mingzejin11/FYDP/hardware/Images/3D PCB with names.png

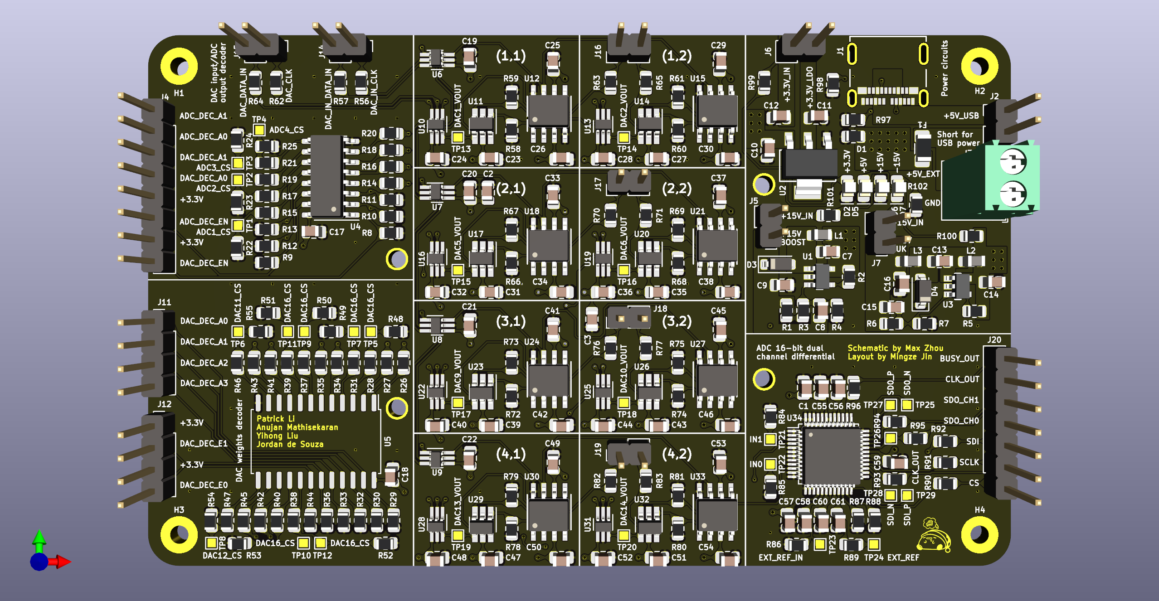
hardware/Images/3D PCB with names.png
