mingzejin11/FYDP/hardware/Images/3D PCB front 2.png

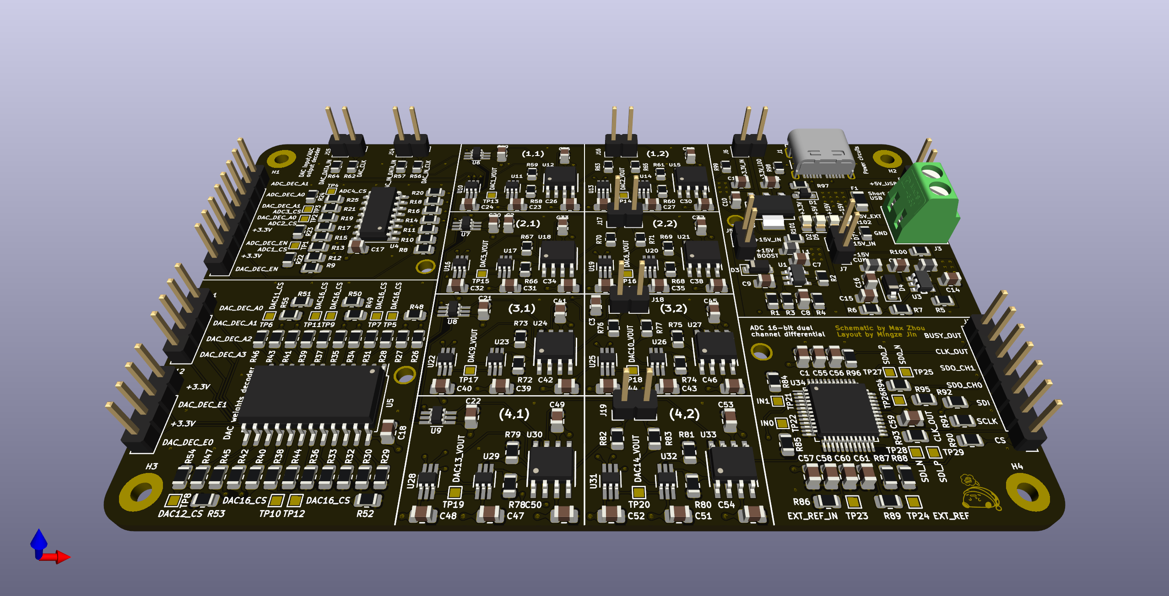
hardware/Images/3D PCB front 2.png
