mingzejin11/FYDP/hardware/fydp/BLOCK_DIAGRAM.png

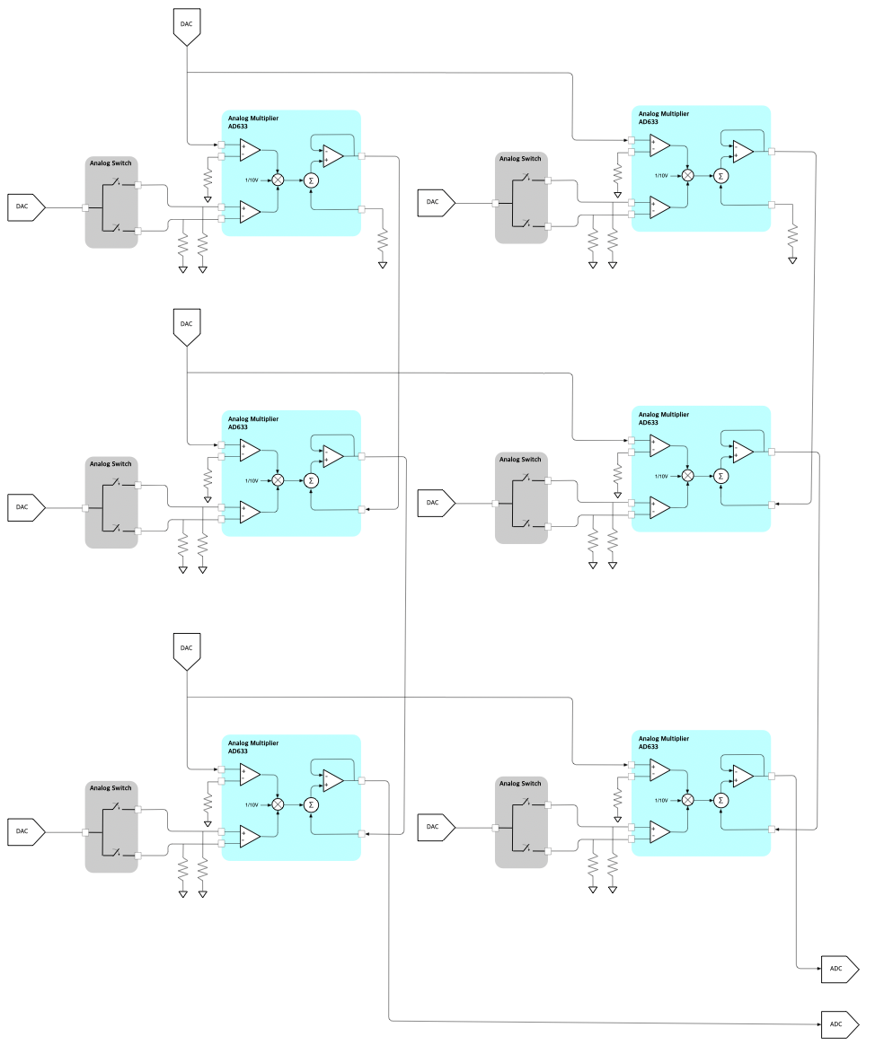
hardware/fydp/BLOCK_DIAGRAM.png
