mingzejin11/FYDP/hardware/Images/3D PCB back.png

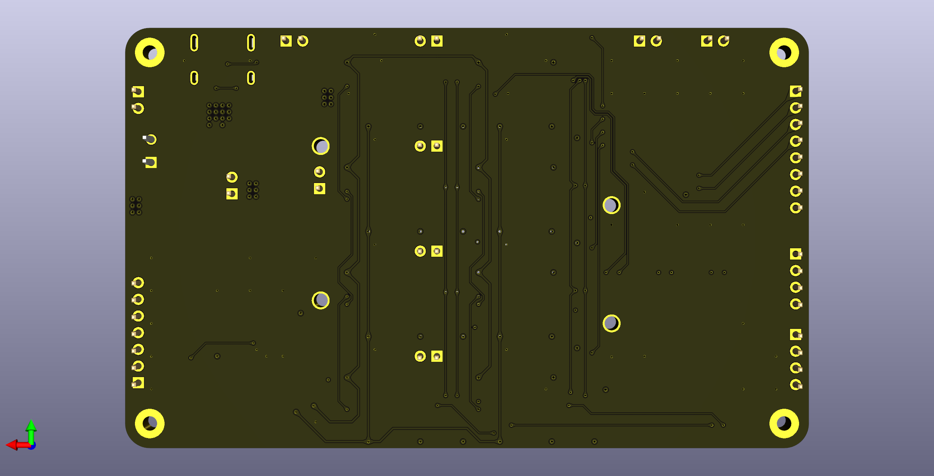
hardware/Images/3D PCB back.png
