mingzejin11/FYDP/hardware/Images/3D PCB front.png

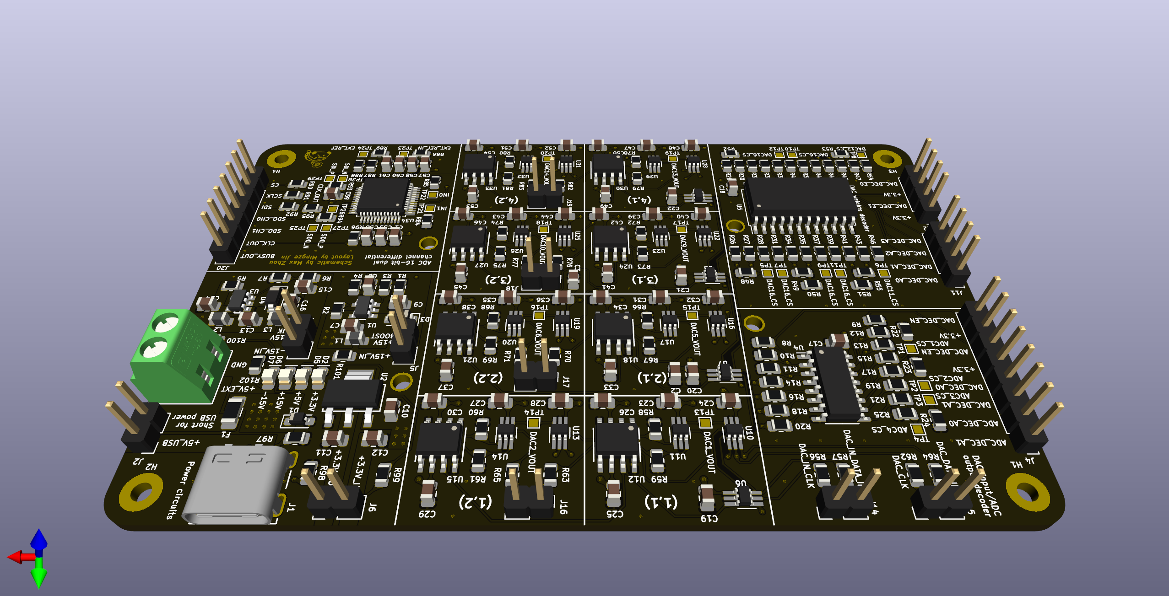
hardware/Images/3D PCB front.png
