mingzejin11/FYDP/hardware/Images/3D PCB.png

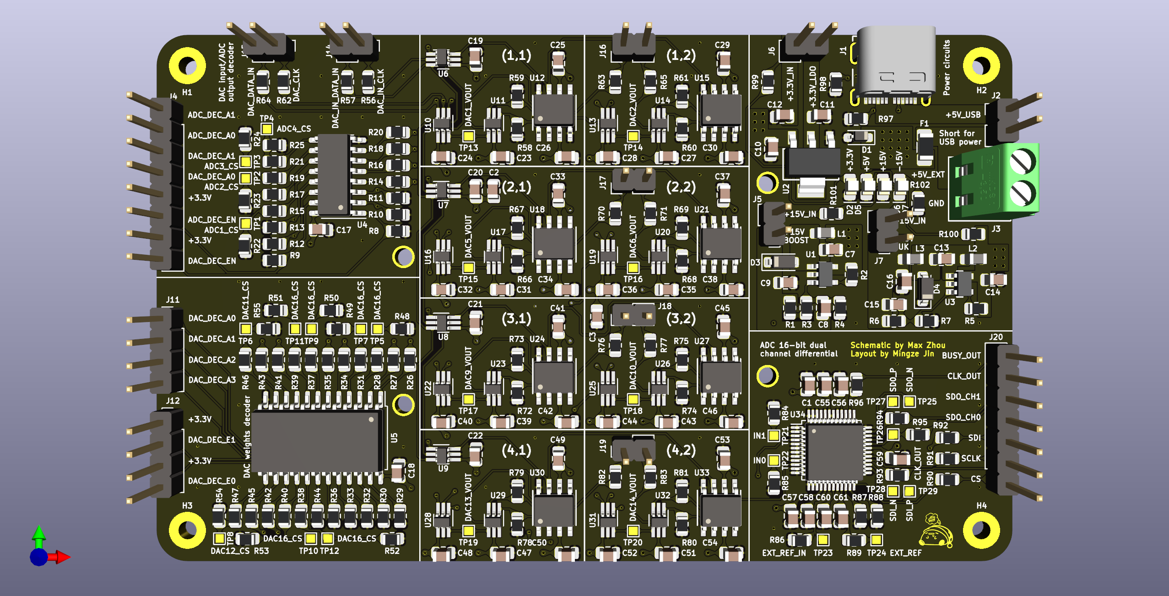
hardware/Images/3D PCB.png
