mingzejin11/FYDP/hardware/Images/fydp.png

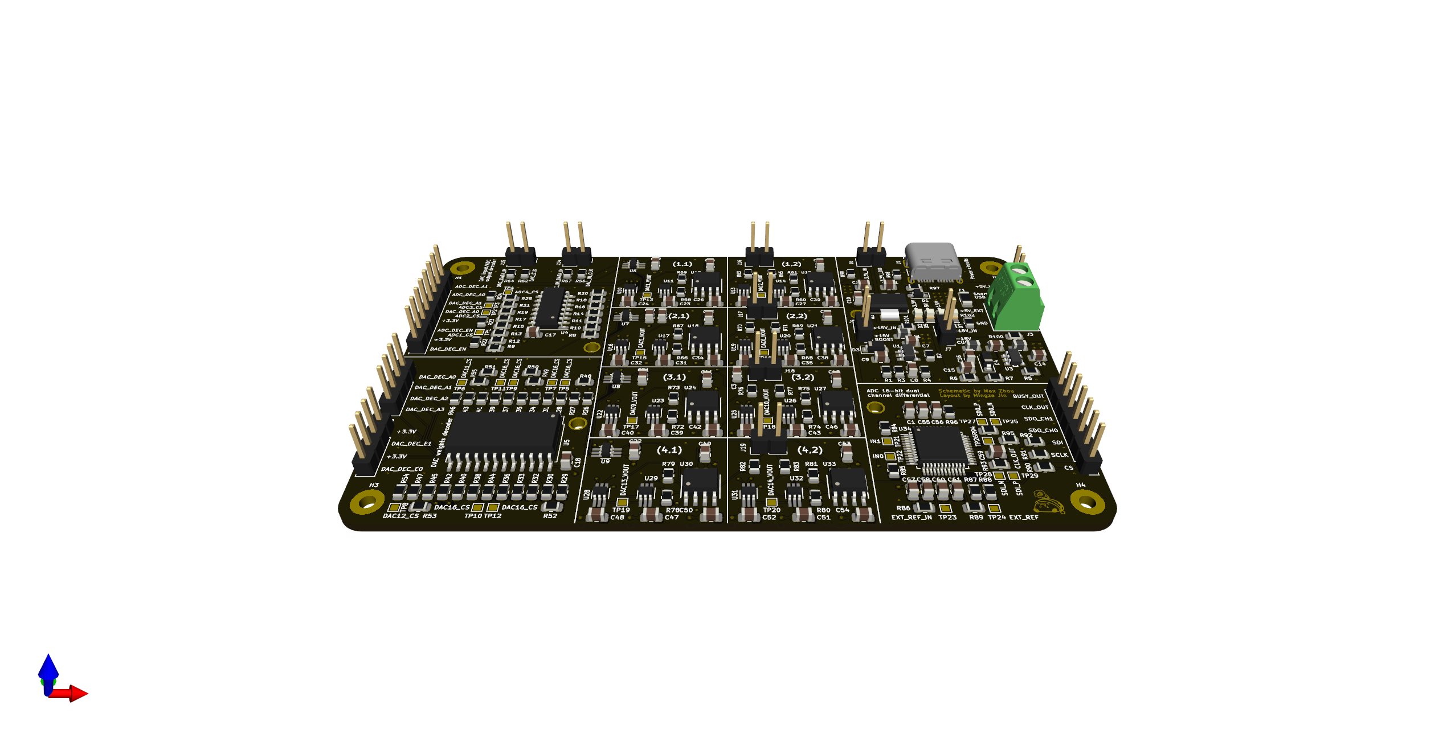
hardware/Images/fydp.png
