mingzejin11/FYDP/hardware/Images/PCB Layout.png

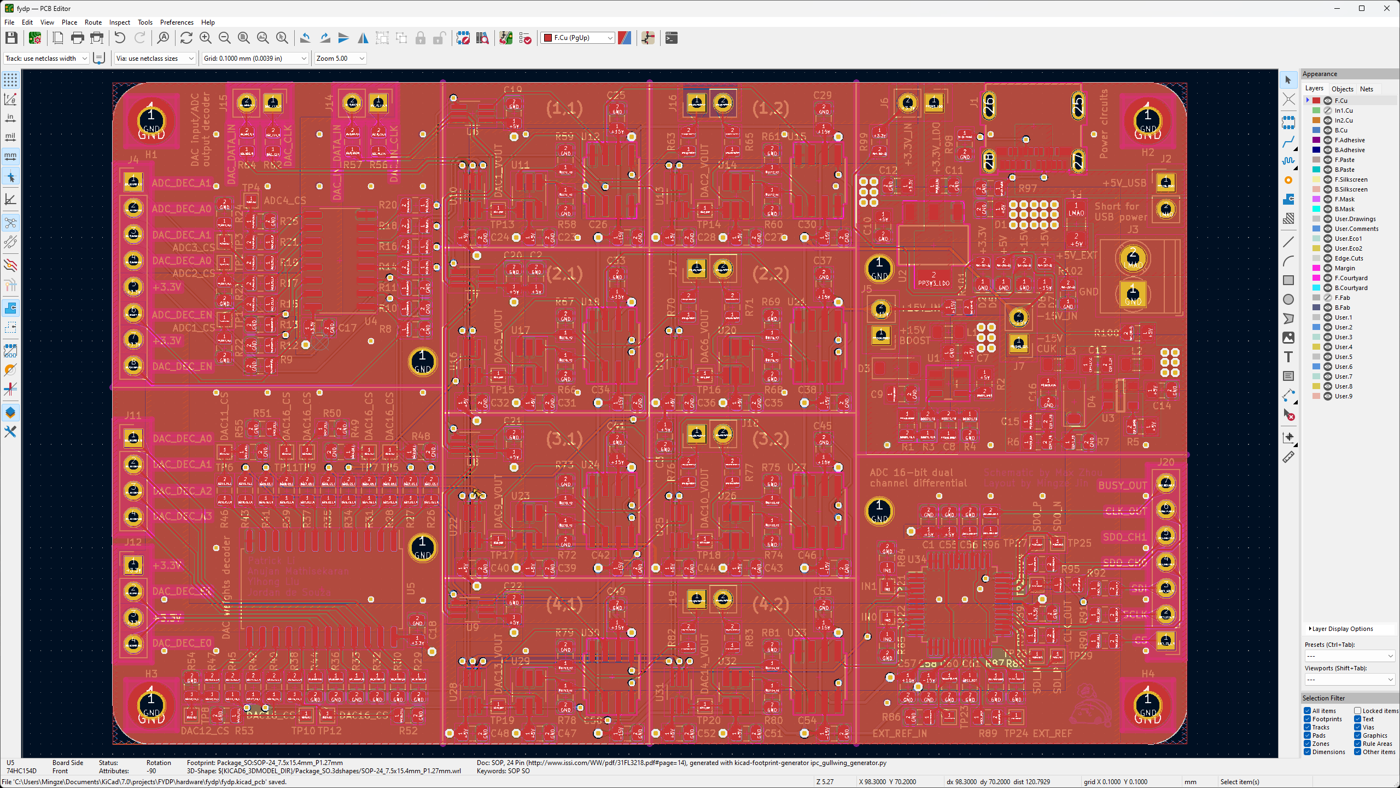
hardware/Images/PCB Layout.png
