mingzejin11/FYDP/Renderings/Animation.gif

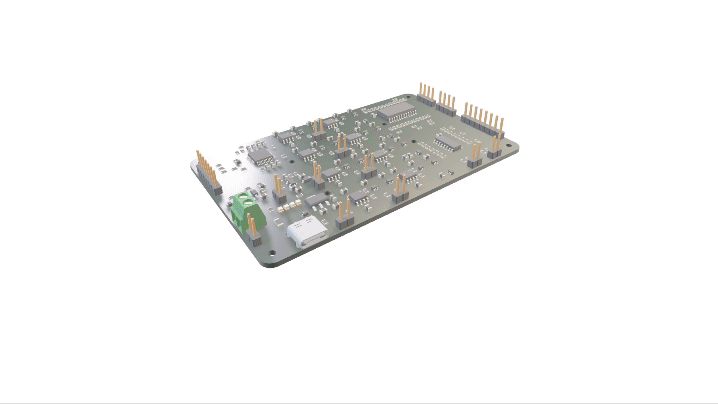
Renderings/Animation.gif
