mingzejin11/FYDP/hardware/Case/DXF/2007/FYDP Case.dxf

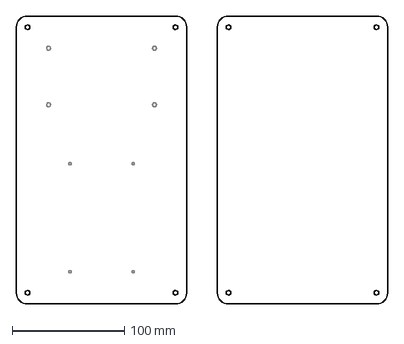
[picture p12: CAD file, 2024-03-12]
hardware/Case/DXF/2007/FYDP Case.dxf
331.3 x 257.0 mm
