mingzejin11/FYDP/hardware/Case/KiCAD DXF/fydp-B_Cu.dxf

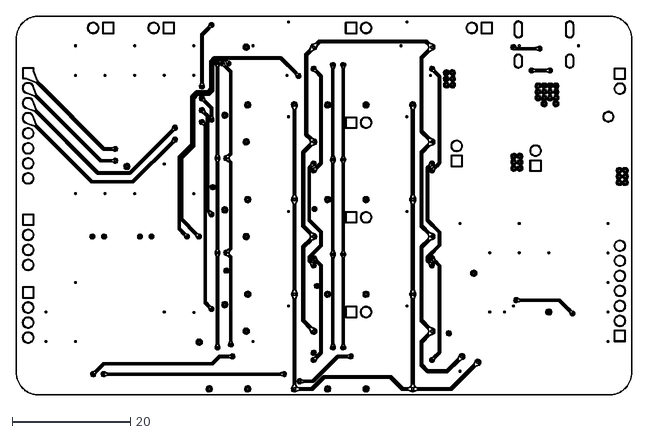
[picture p16: CAD file, 2024-03-11]
hardware/Case/KiCAD DXF/fydp-B_Cu.dxf
104.0 x 64.0
