mingzejin11/FYDP/hardware/Components/AZ1117IH-3.3TRG1/SOT223-3.step

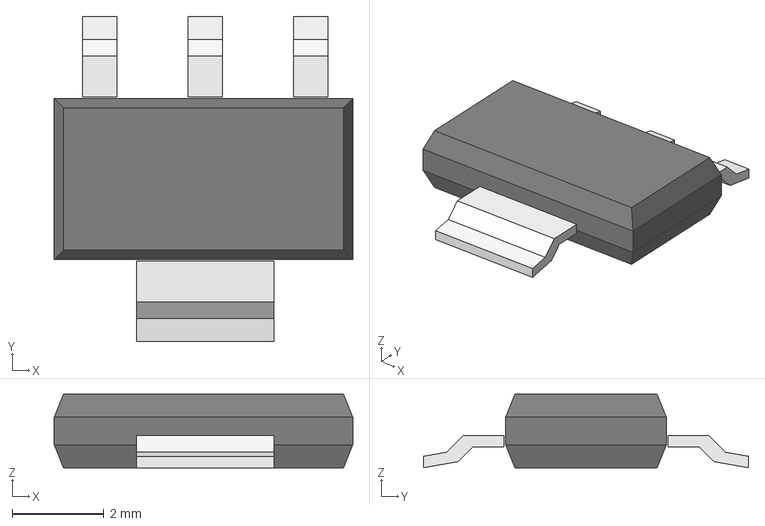
[picture p17: CAD file, 2024-02-02]
hardware/Components/AZ1117IH-3.3TRG1/SOT223-3.step
6.50 x 7.07 x 1.60 mm
