mingzejin11/FYDP/hardware/Components/LM2733YMFXNOPB/SOT23-5.stp

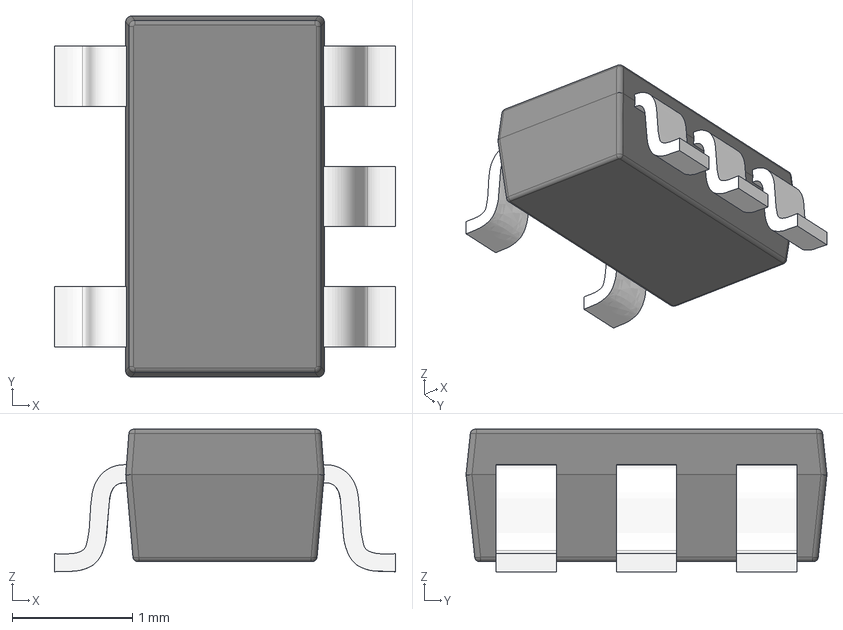
[picture p18: CAD file, 2024-02-02]
hardware/Components/LM2733YMFXNOPB/SOT23-5.stp
2.84 x 3.00 x 1.18 mm
