mingzejin11/FYDP/hardware/Case/DXF/2018/FYDP Case bottom.dxf

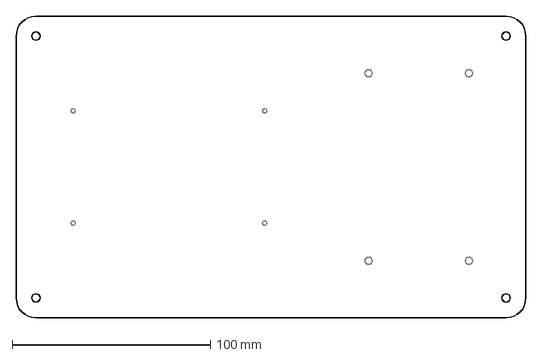
[picture p24: CAD file, 2024-03-11]
hardware/Case/DXF/2018/FYDP Case bottom.dxf
257.0 x 152.0 mm
