mingzejin11/FYDP/hardware/Case/DXF/2013/FYDP Case bottom.dxf

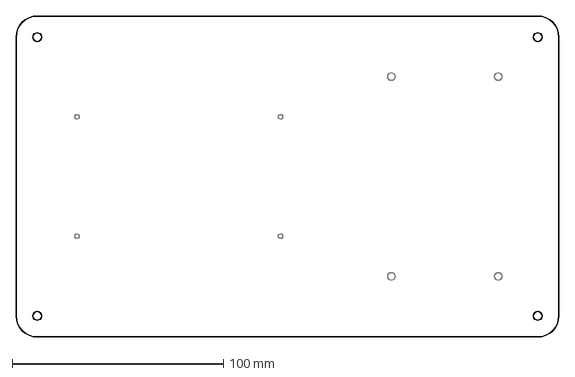
[picture p29: CAD file, 2024-03-11]
hardware/Case/DXF/2013/FYDP Case bottom.dxf
257.0 x 152.0 mm
