mingzejin11/FYDP/hardware/Case/DXF/2018/FYDP Case top.dxf

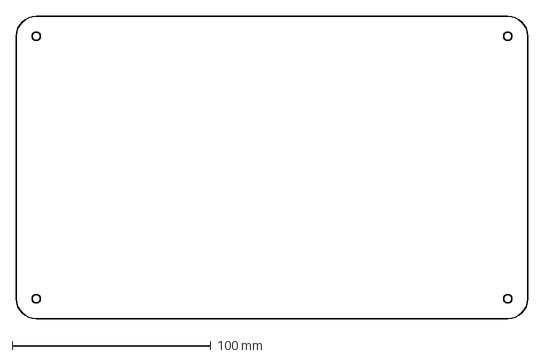
[picture p30: CAD file, 2024-03-11]
hardware/Case/DXF/2018/FYDP Case top.dxf
257.0 x 152.0 mm
