mingzejin11/FYDP/hardware/Case/KiCAD DXF/fydp-In1_Cu.dxf

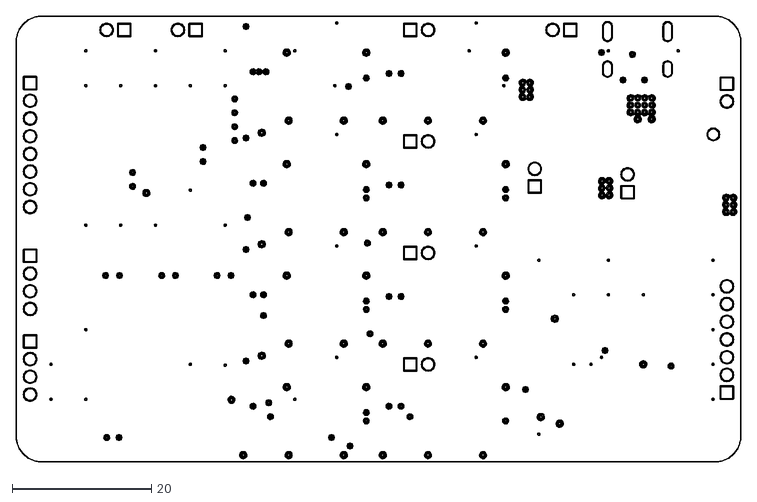
[picture p31: CAD file, 2024-03-11]
hardware/Case/KiCAD DXF/fydp-In1_Cu.dxf
104.0 x 64.0
