mingzejin11/FYDP/hardware/Case/KiCAD DXF/fydp-In2_Cu.dxf

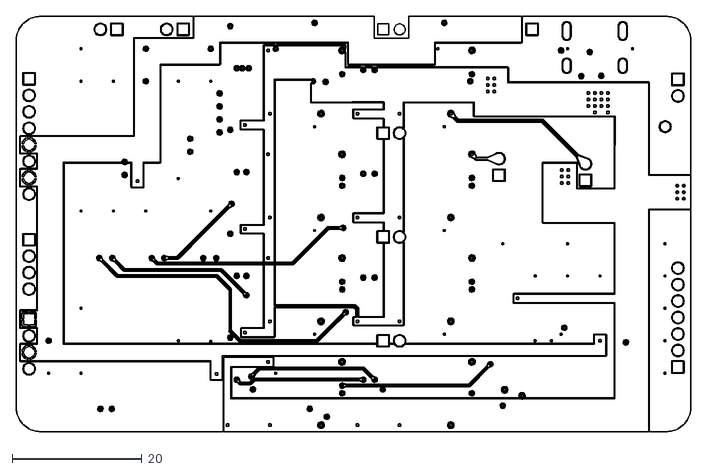
[picture p32: CAD file, 2024-03-11]
hardware/Case/KiCAD DXF/fydp-In2_Cu.dxf
104.0 x 64.0
