mingzejin11/FYDP/hardware/Case/KiCAD DXF/fydp-Edge_Cuts.dxf

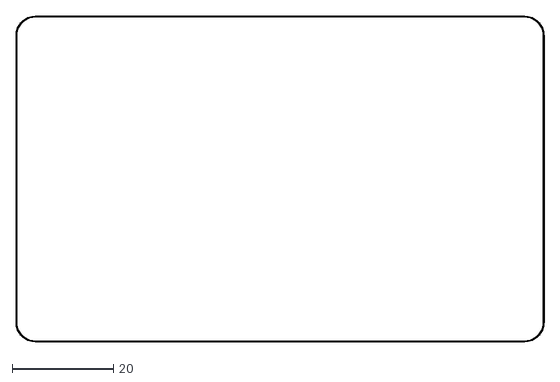
[picture p33: CAD file, 2024-03-11]
hardware/Case/KiCAD DXF/fydp-Edge_Cuts.dxf
104.1 x 64.1
