mingzejin11/FYDP/(list of files, cad)

Other CAD files:
hardware/Case/FYDP Case.dwg
hardware/Case/FYDP Case bottom.dwg
hardware/Case/KiCAD DXF/FYDP outline.dwg
hardware/Case/FYDP Case top.dwg
hardware/Case/KiCAD DXF/fydp-B_Mask.dxf
hardware/Case/KiCAD DXF/fydp-B_Paste.dxf
hardware/Case/KiCAD DXF/fydp-B_Silkscreen.dxf
hardware/Case/KiCAD DXF/fydp-F_Mask.dxf
hardware/Case/KiCAD DXF/fydp-F_Paste.dxf
