mingzejin11/FYDP/hardware/fydp/fydp.pdf

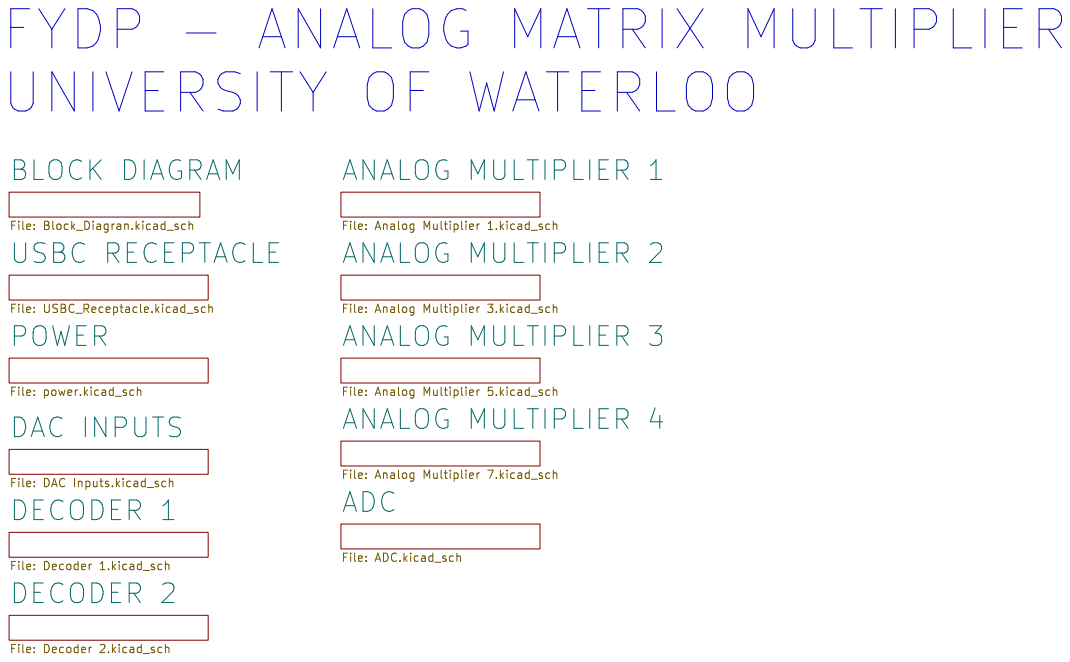
[picture p34: page 1]

File: ADC.kicad_sch FYDP - ANALOG MATRIX MULTIPLIER
UNIVERSITY OF WATERLOO

Id: 1/12 Title: File: fydp.kicad_sch Sheet: / BLOCK DIAGRAM

File: power.kicad_sch
File: Decoder 1.kicad_sch DAC INPUTS

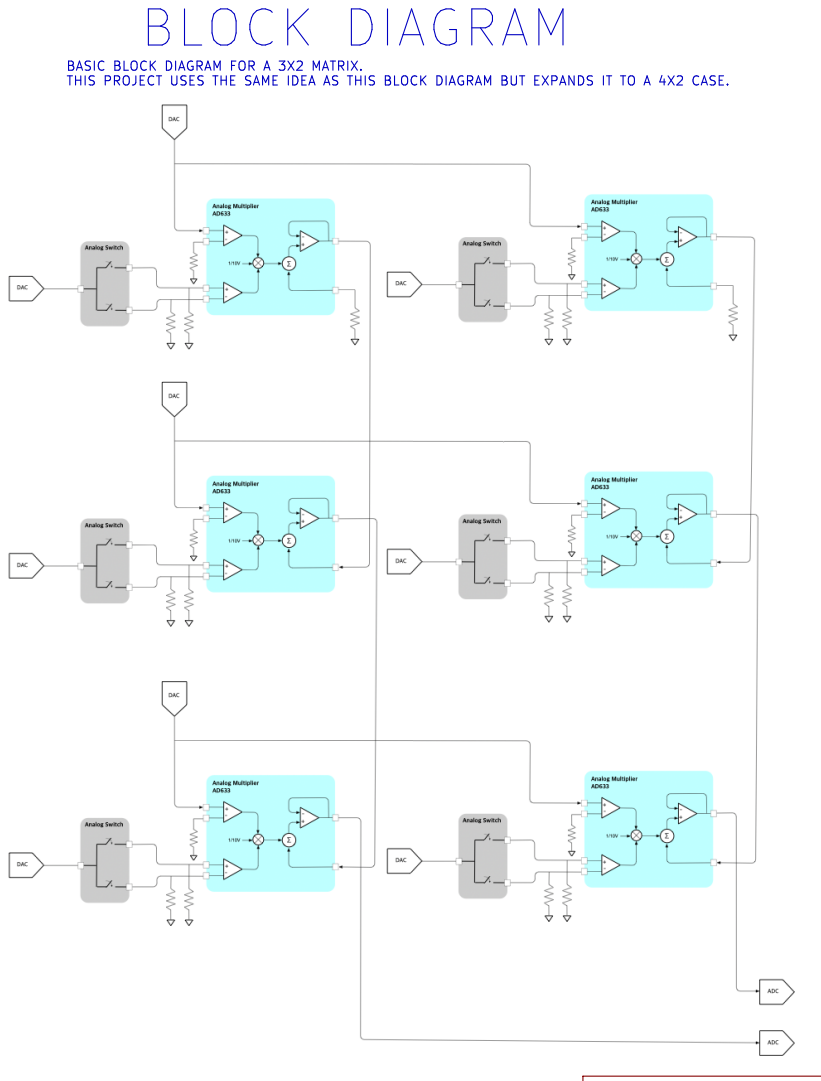
[picture p35: page 2]

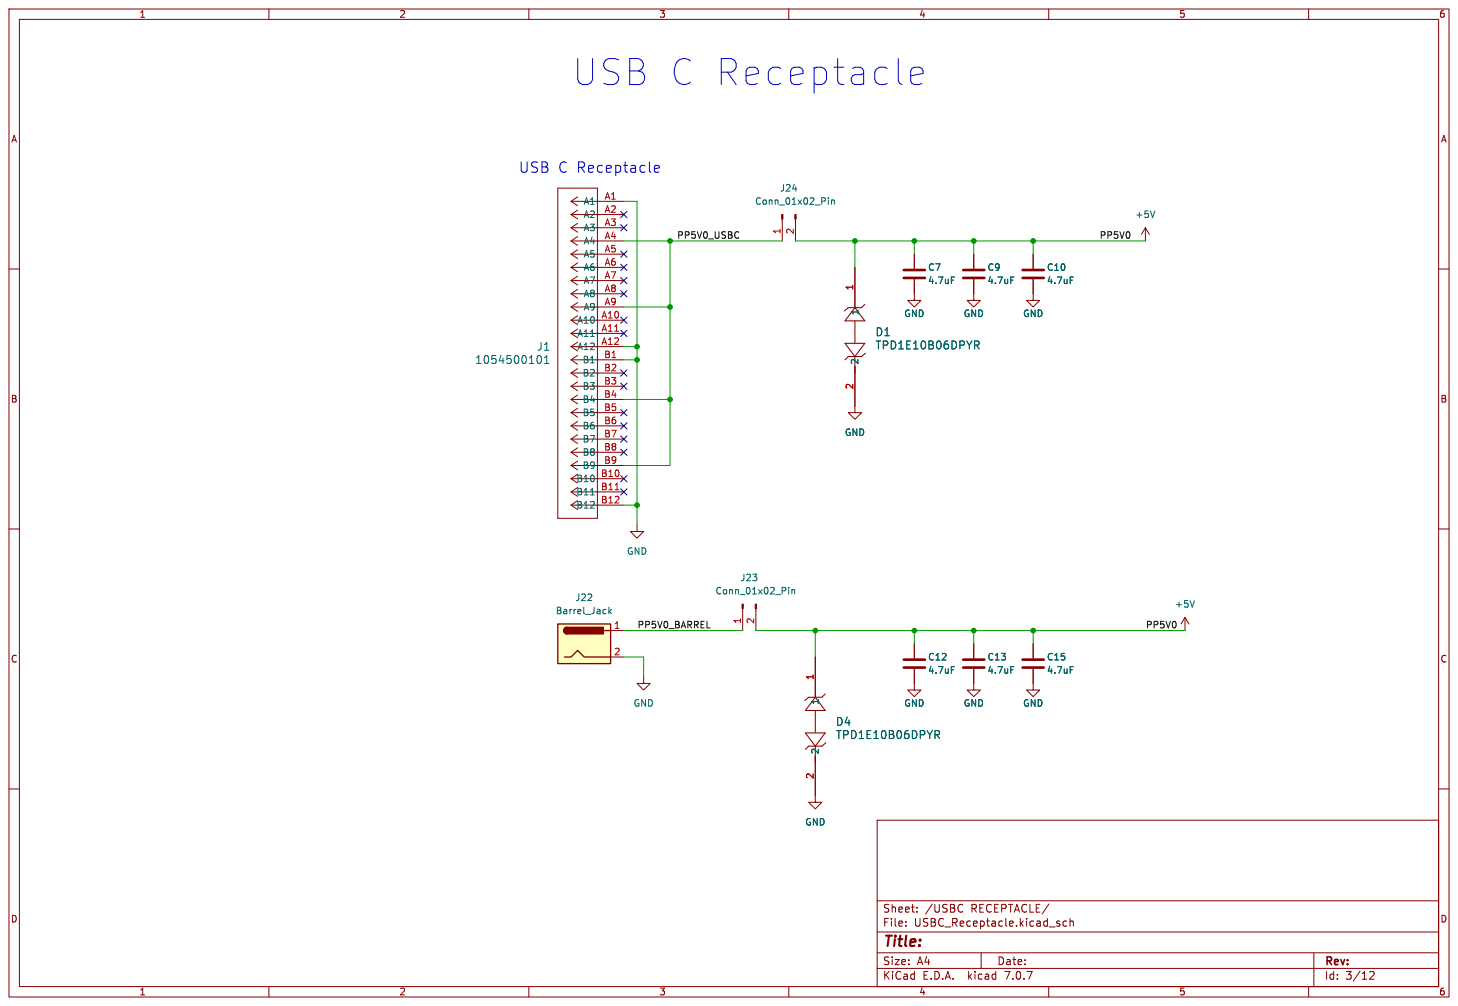
[picture p36: page 3]

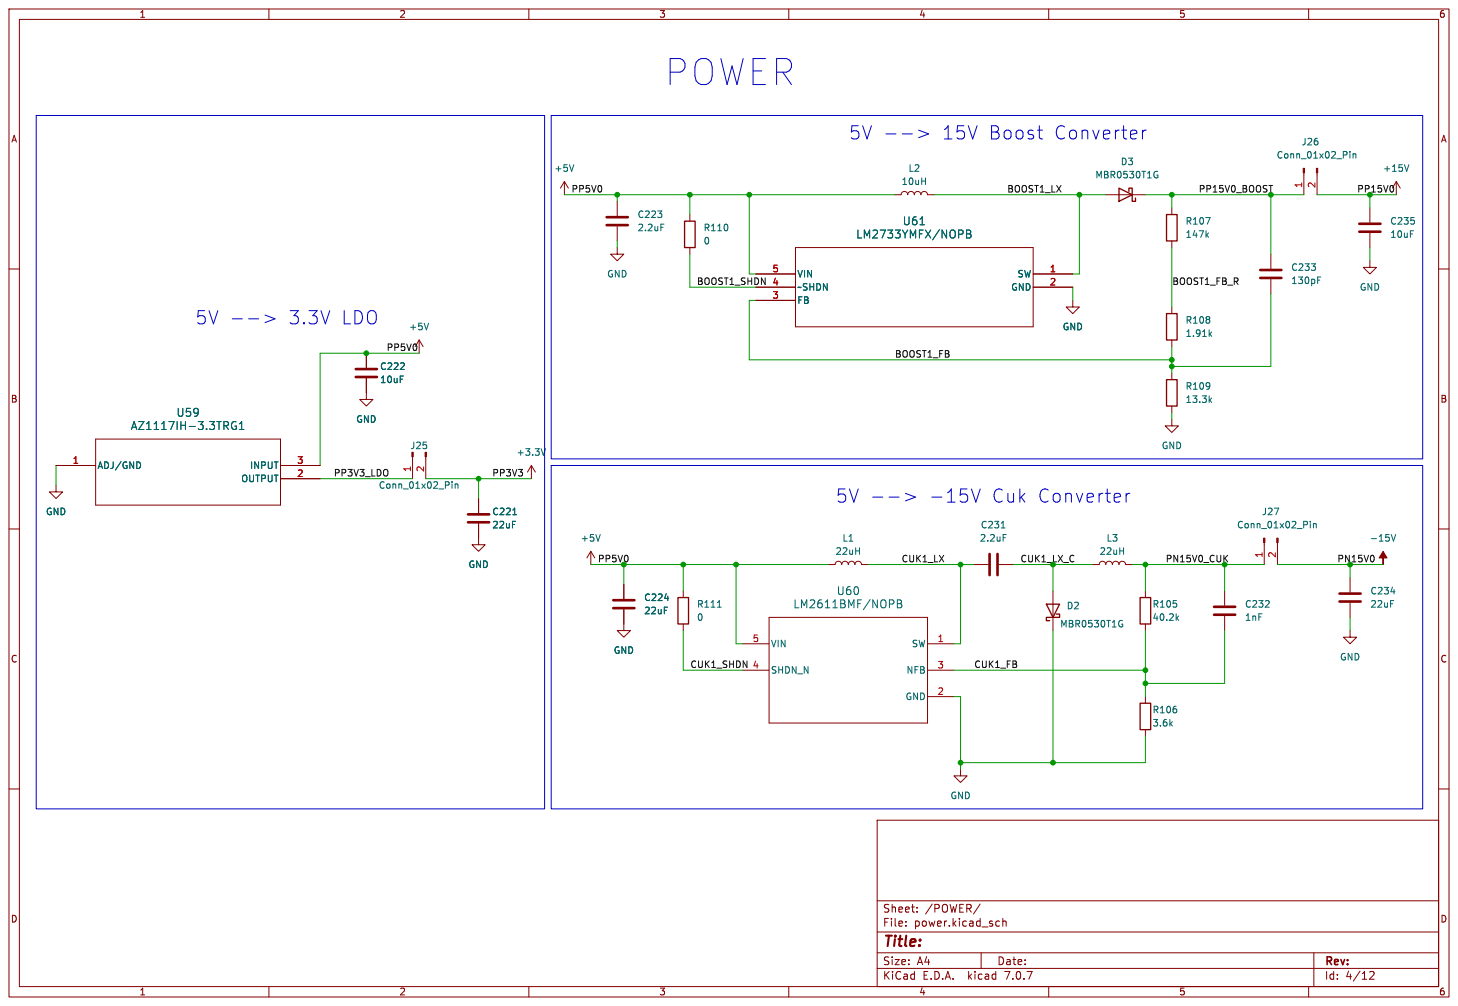
[picture p37: page 4]

Id: 4/12 Title: File: power.kicad_sch Sheet: /POWER/

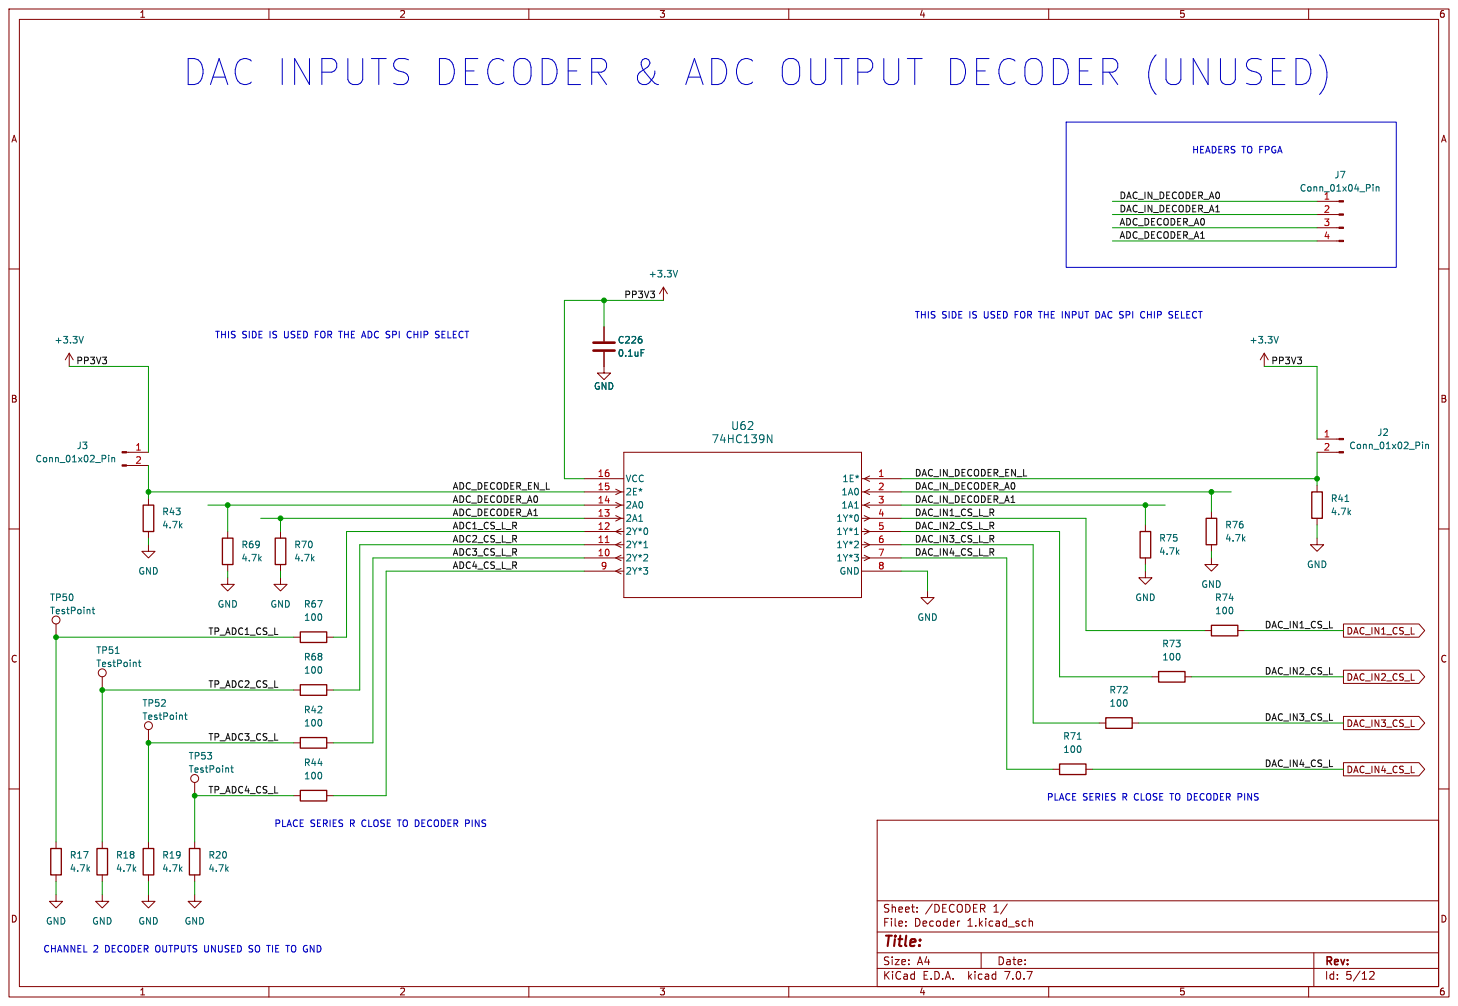
[picture p38: page 5]

DAC_IN4_CS_L_R DAC INPUTS DECODER & ADC OUTPUT DECODER (UNUSED)

THIS SIDE IS USED FOR THE INPUT DAC SPI CHIP SELECT CHANNEL 2 DECODER OUTPUTS UNUSED SO TIE TO GND

THIS SIDE IS USED FOR THE ADC SPI CHIP SELECT PLACE SERIES R CLOSE TO DECODER PINS

PLACE SERIES R CLOSE TO DECODER PINS

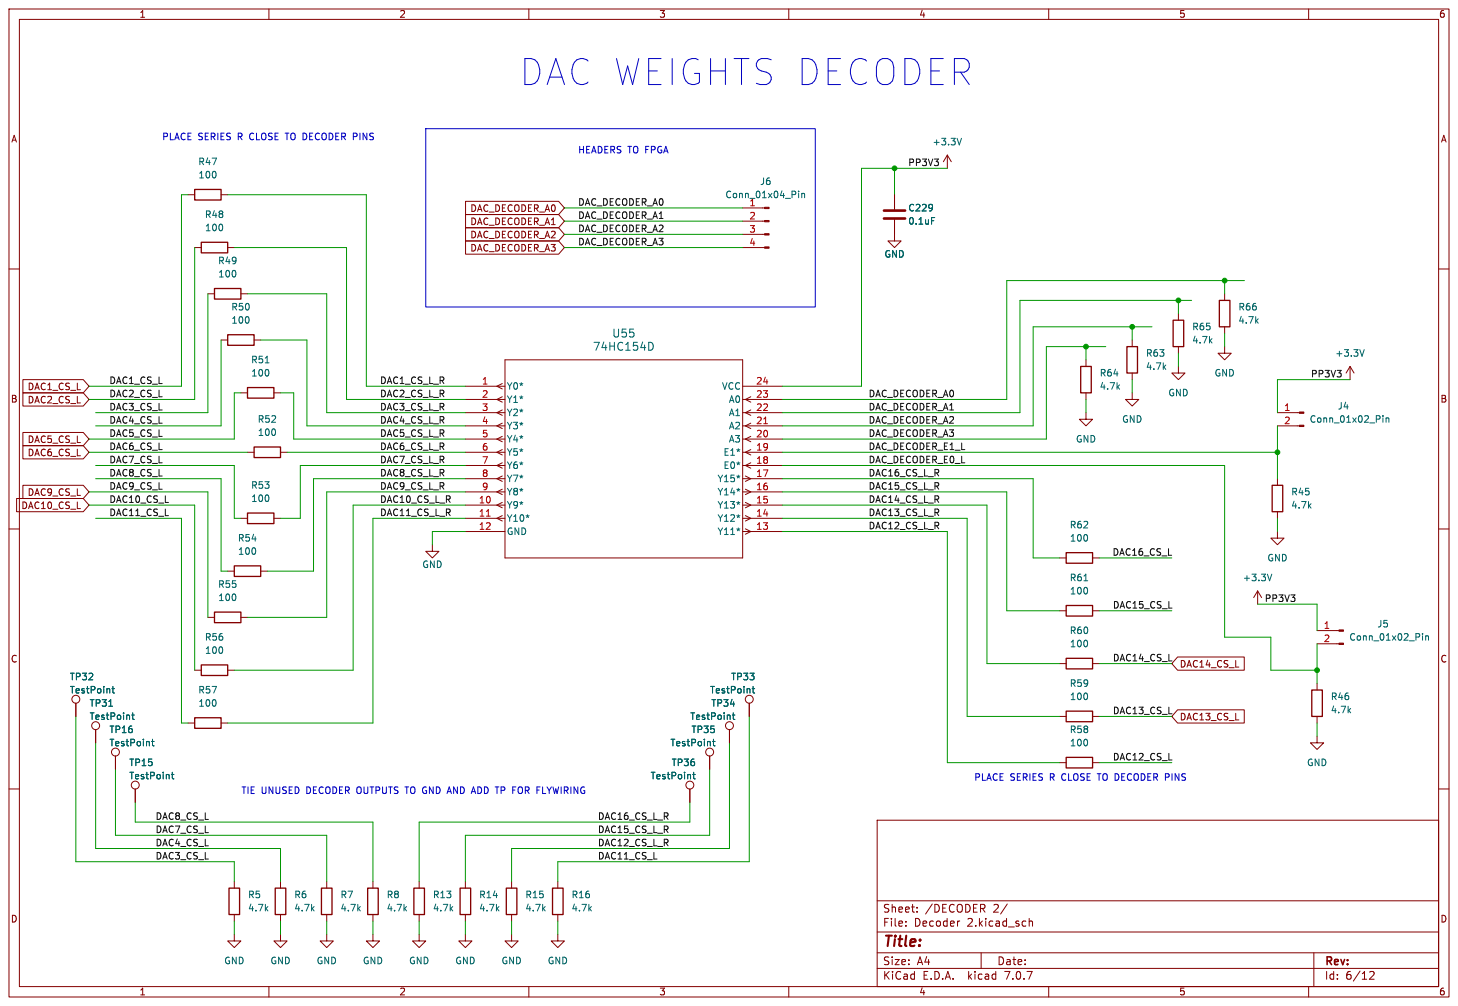
[picture p39: page 6]

TIE UNUSED DECODER OUTPUTS TO GND AND ADD TP FOR FLYWIRING DAC WEIGHTS DECODER

PLACE SERIES R CLOSE TO DECODER PINS

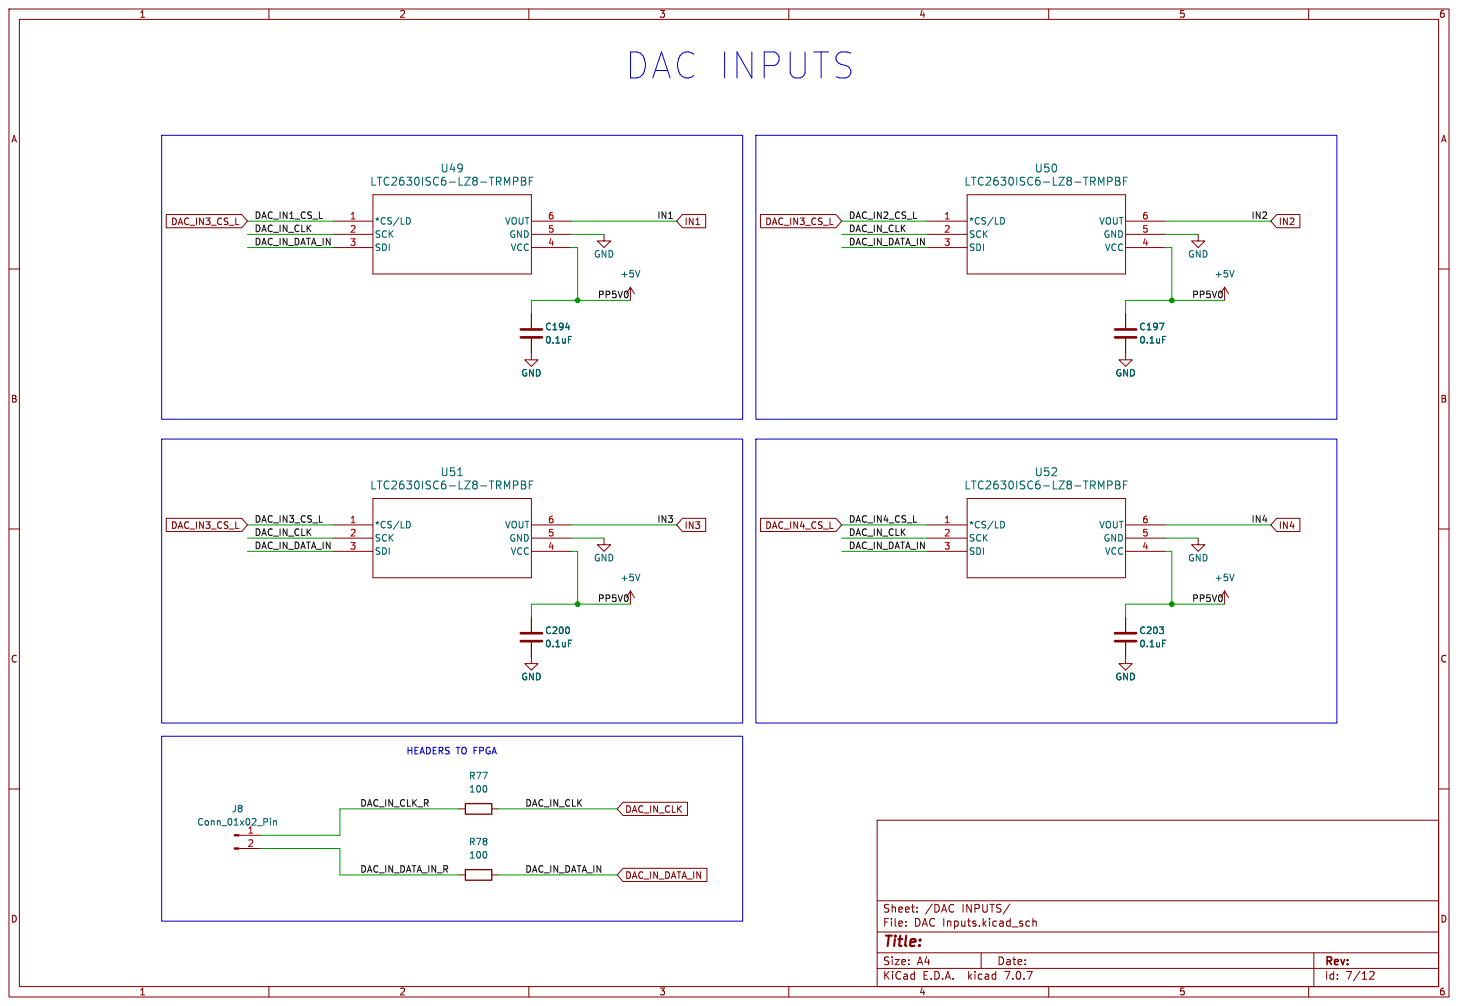
[picture p40: page 7]

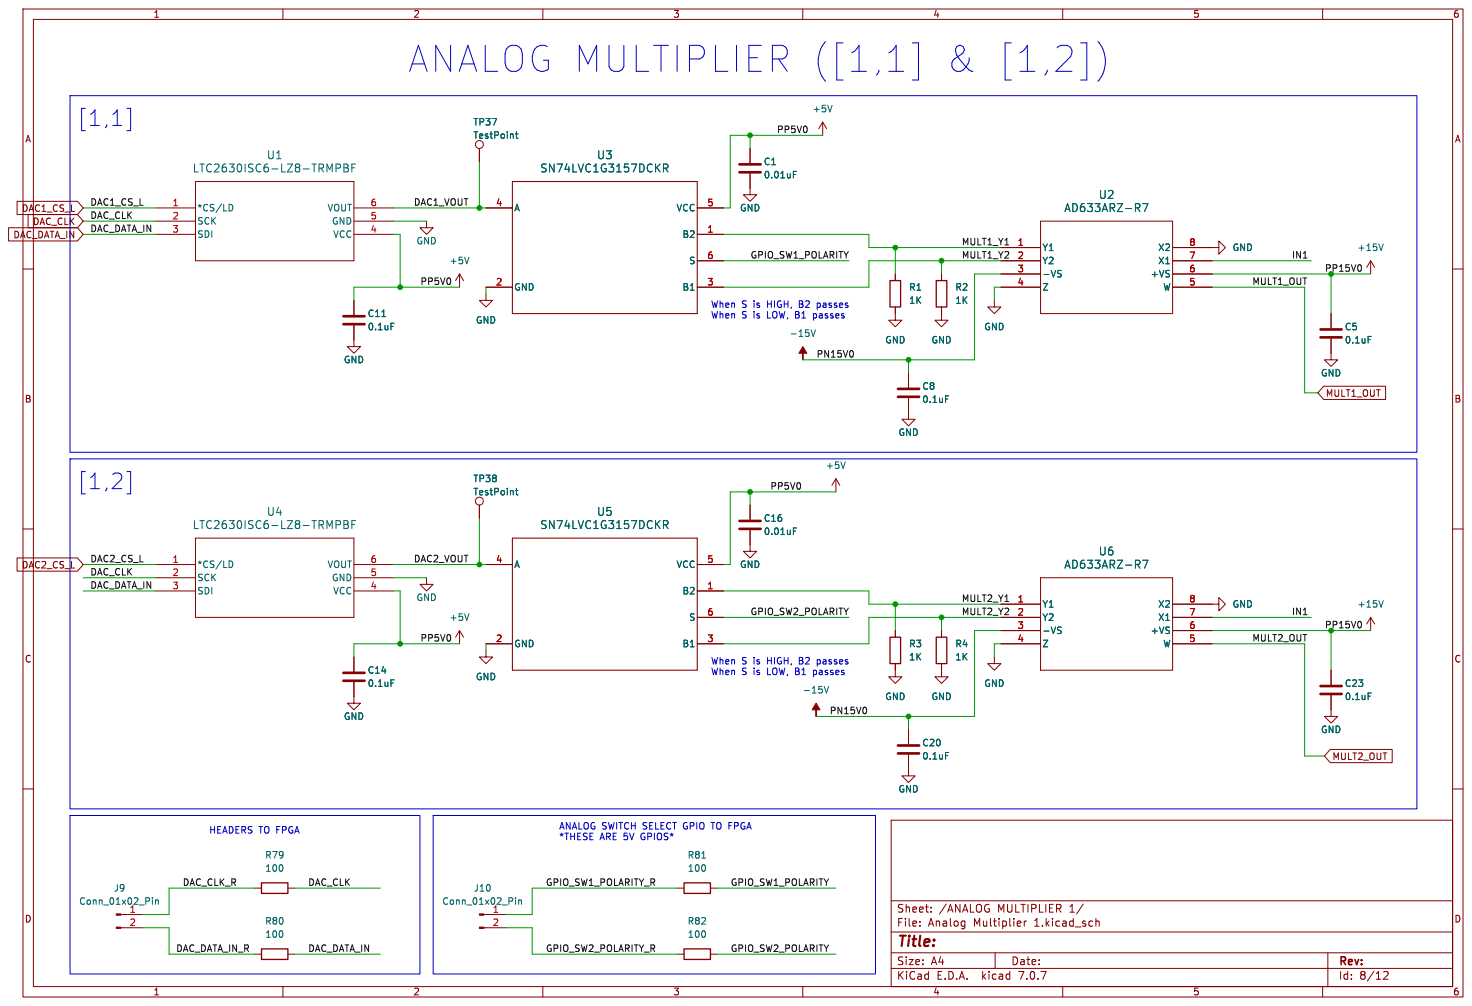
[picture p41: page 8]

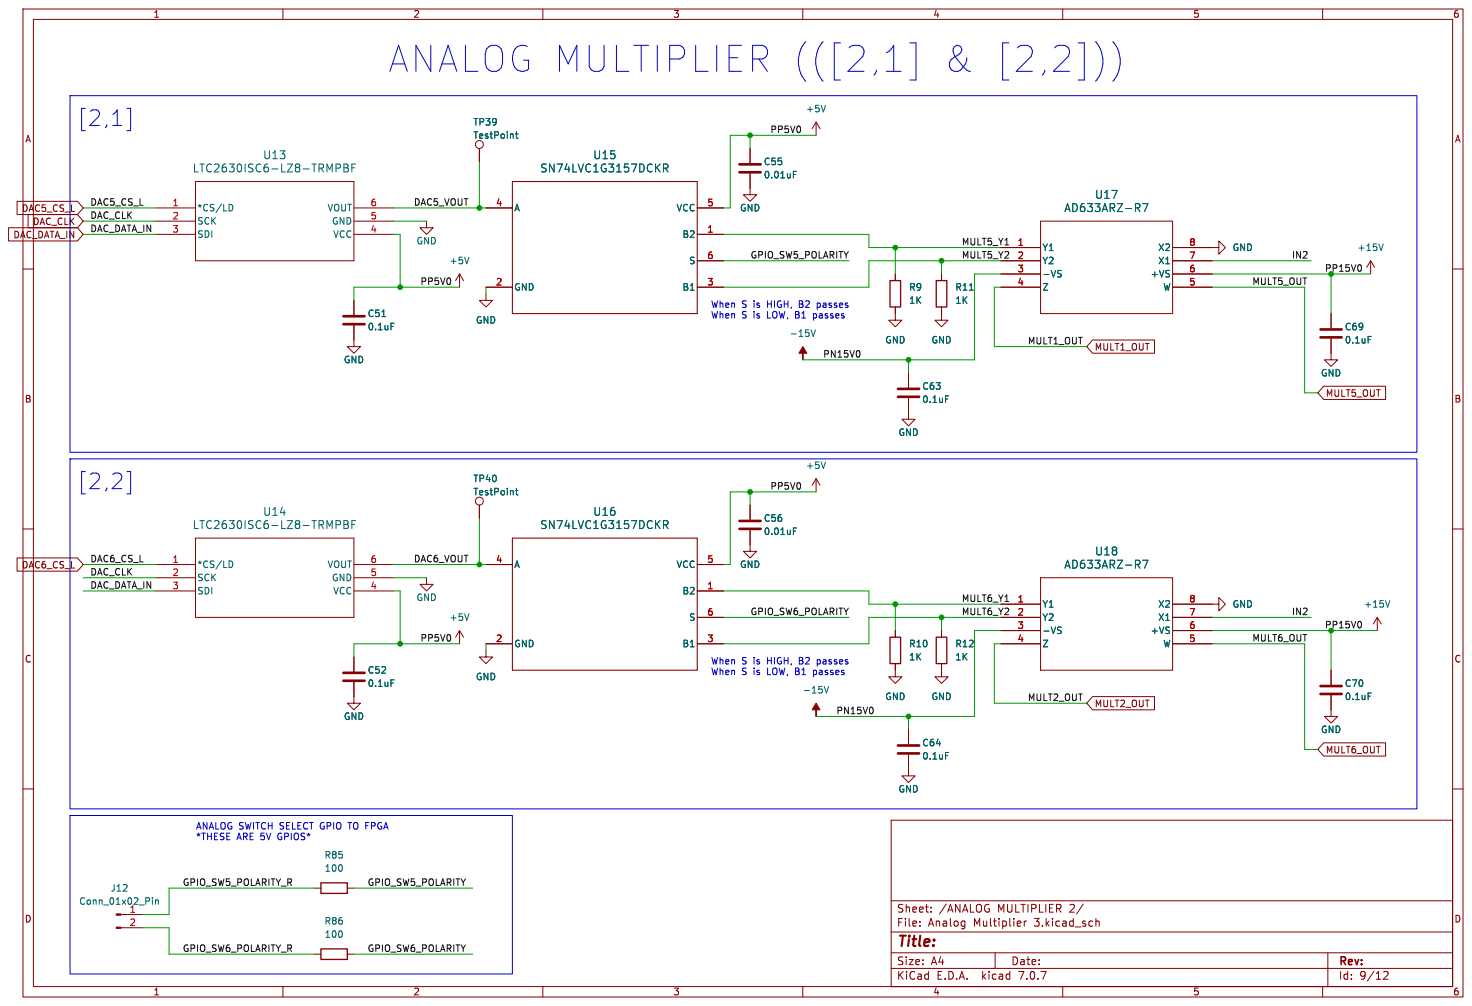
[picture p42: page 9]

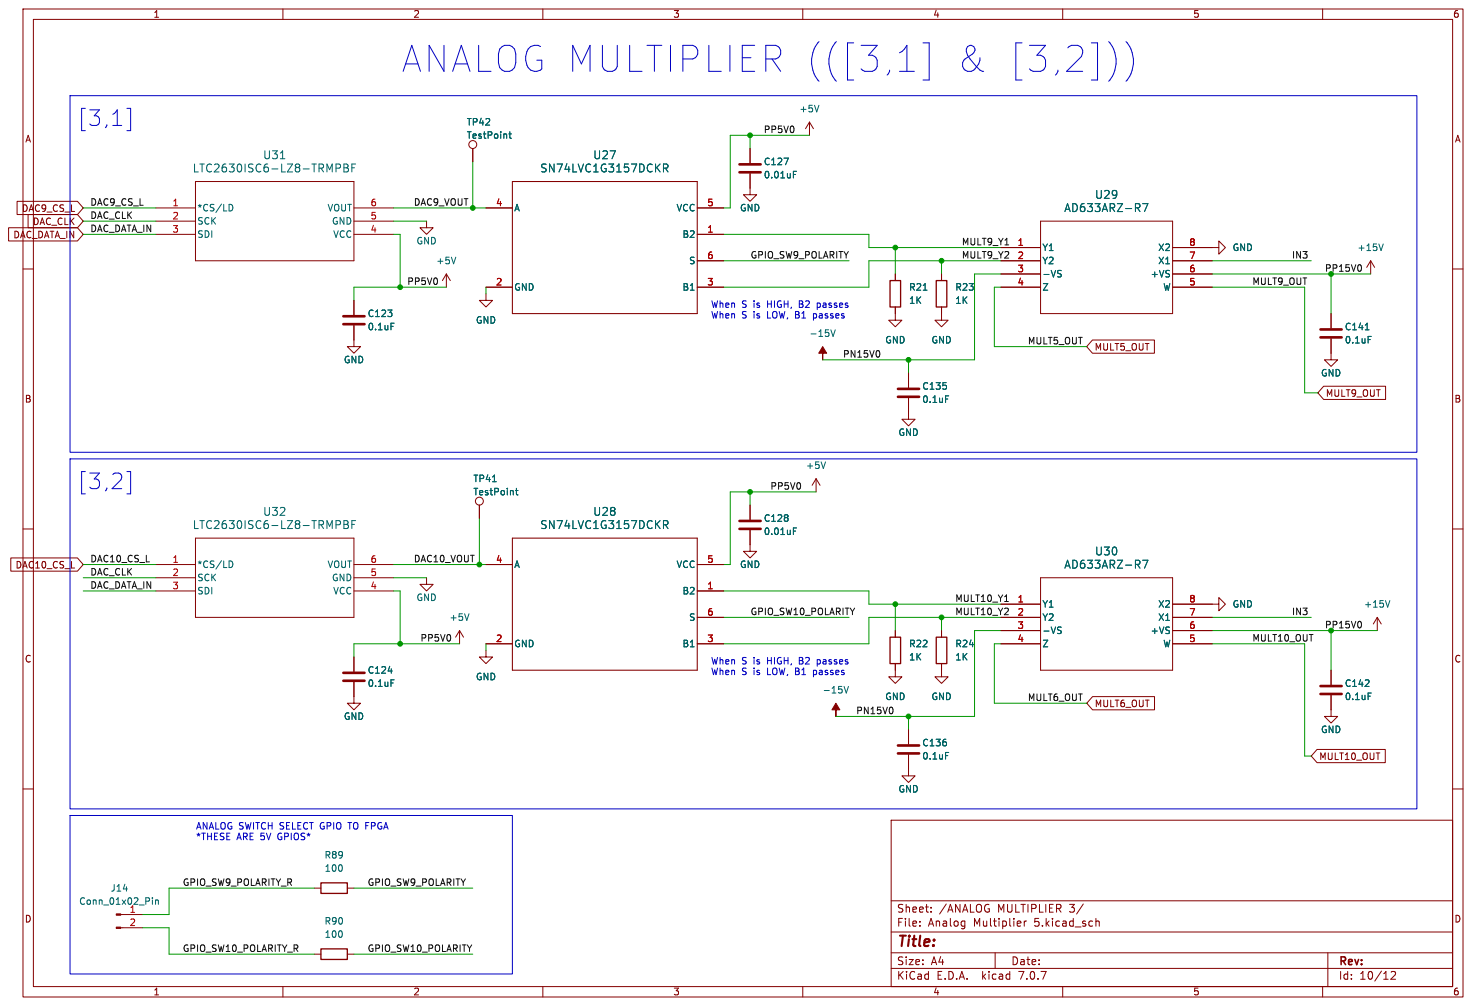
[picture p43: page 10]

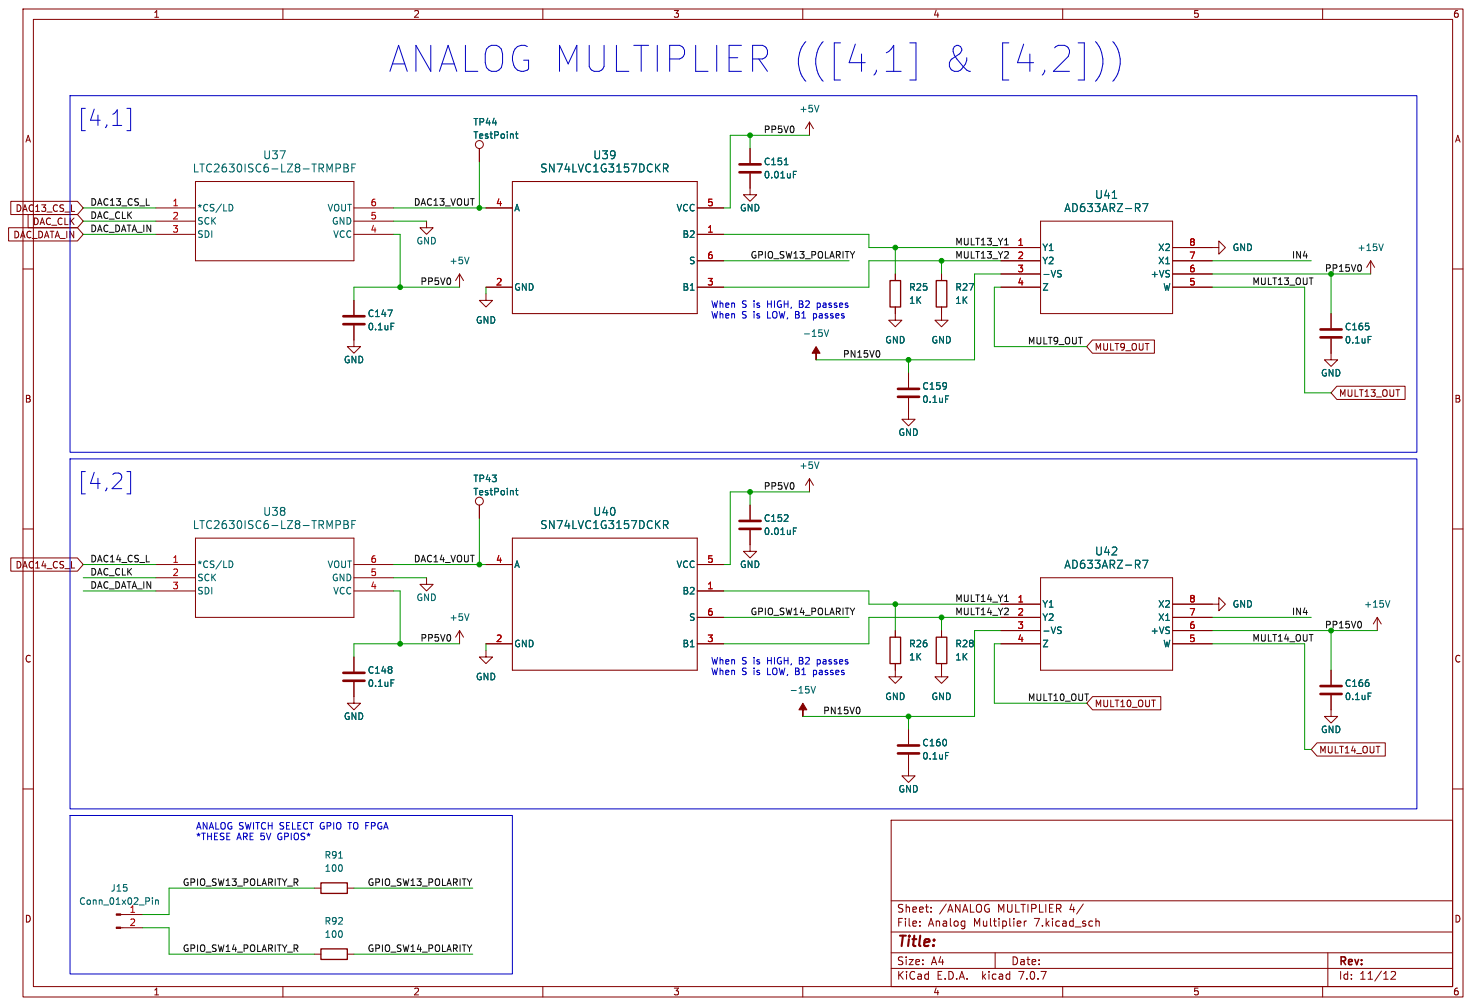
[picture p44: page 11]

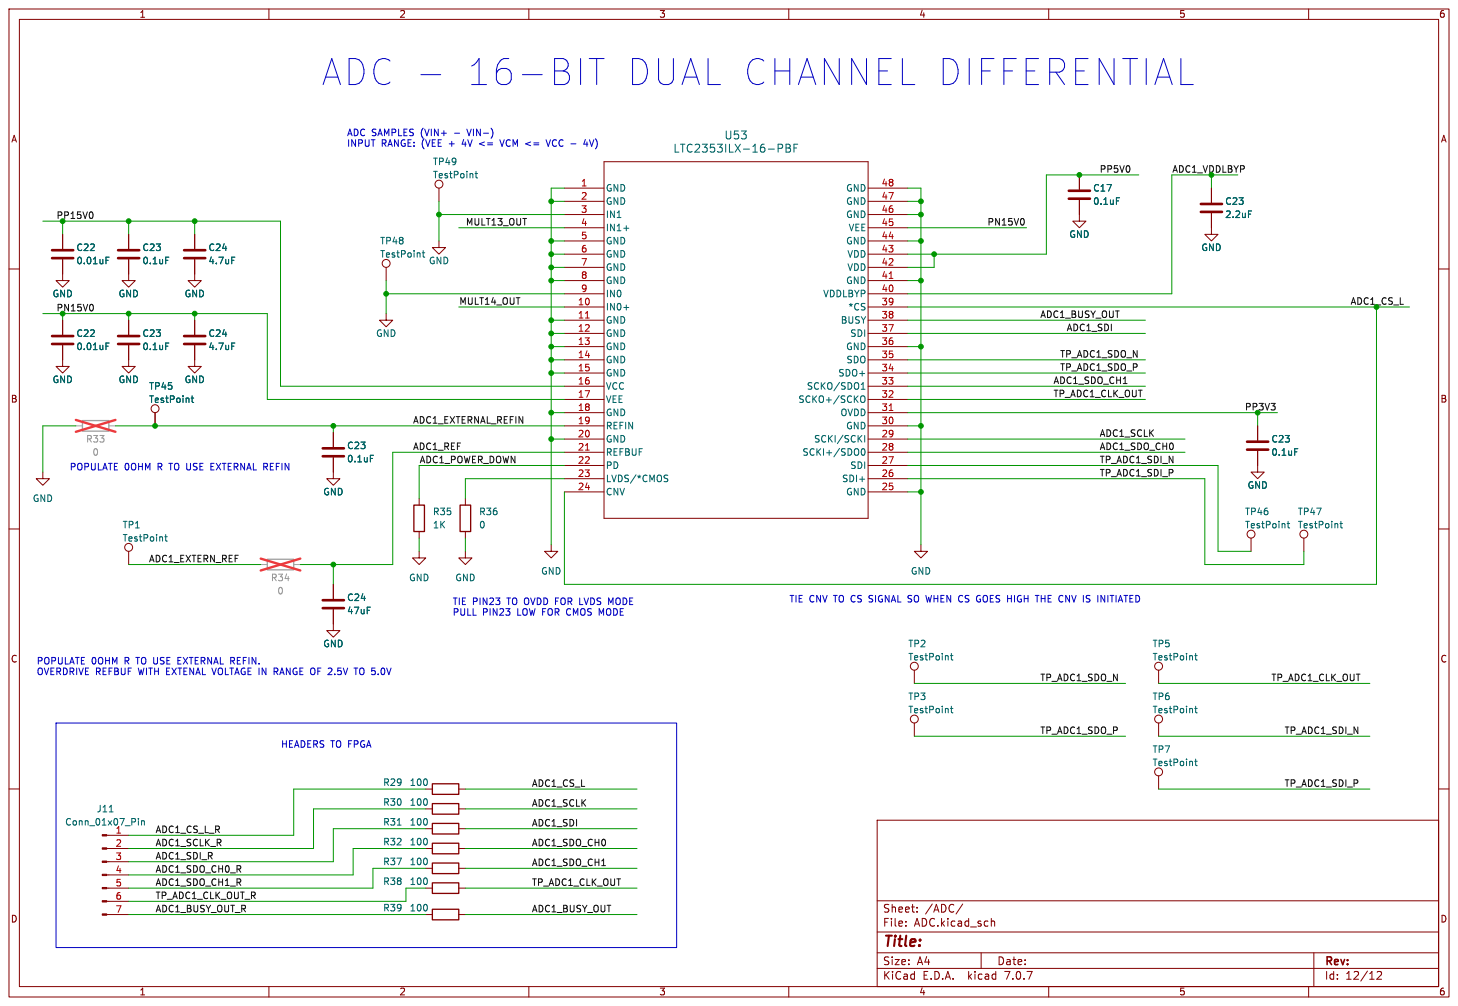
[picture p45: page 12]

ADC - 16-BIT DUAL CHANNEL DIFFERENTIAL

ADC SAMPLES (VIN+ - VIN-)
INPUT RANGE: (VEE + 4V <= VCM <= VCC - 4V)

PULL PIN23 LOW FOR CMOS MODE C24

POPULATE 0OHM R TO USE EXTERNAL REFIN

TP6 TestPoint GND GND
Id: 12/12 Title: File: ADC.kicad_sch Sheet: /ADC/ C24
47uF GND

POPULATE 0OHM R TO USE EXTERNAL REFIN. OVERDRIVE REFBUF WITH EXTENAL VOLTAGE IN RANGE OF 2.5V TO 5.0V HEADERS TO FPGA
