mingzejin11/FYDP/hardware/fydp/fydp.kicad_pcb

## KiCad design hardware/fydp/fydp.kicad_pcb (2024-02-02)

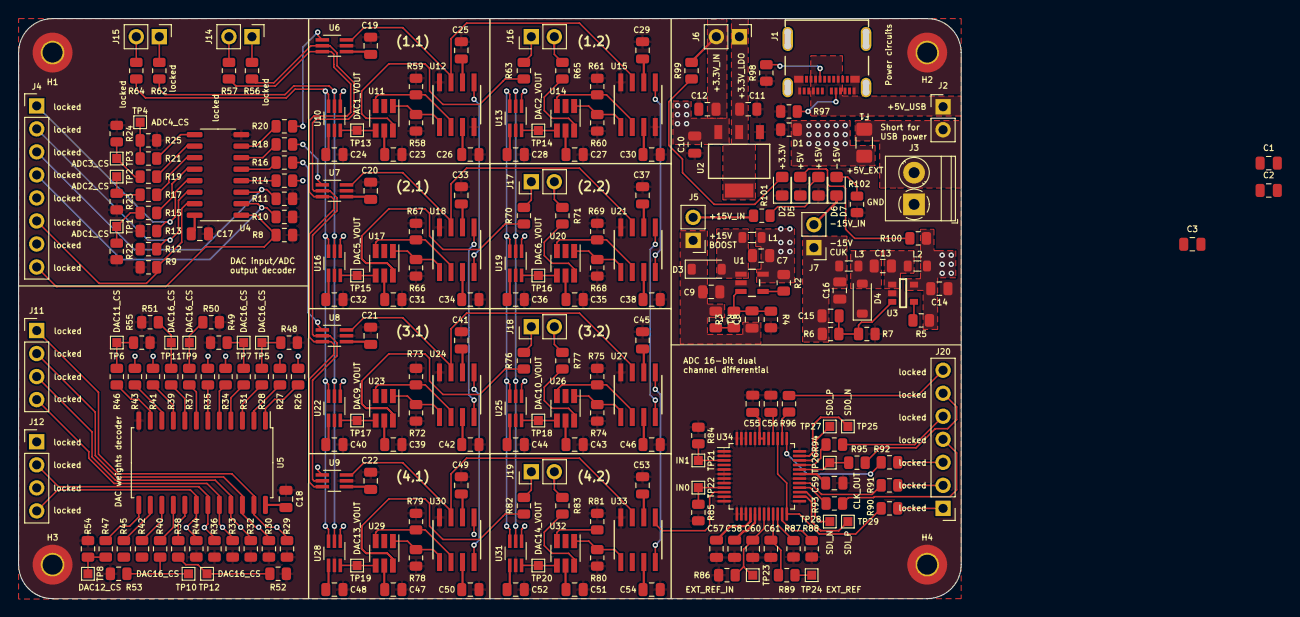
[picture p46: board fydp.kicad_pcb from above]

Board: 2 copper layers, 104.0 x 64.0 mm, 254 parts (0 on the bottom side), 170 nets.

Parts:
C1, C2, C3: 4.7uF; C_0805_2012Metric
C7, C13, C56: 2.2uF; C_0805_2012Metric
C8: 130pF; C_0805_2012Metric
C9, C10: 10uF; C_0805_2012Metric
C11, C12, C14, C16: 22uF; C_0805_2012Metric
C15: 1nF; C_0805_2012Metric
C17, C18, C19, C20, C21, C22, C24, C25, C26, C28, C29, C30, C32, C33, C34, C36, C37, C38, C40, C41, C42, C44, C45, C46, C48, C49, C50, C52, C53, C54, C55, C57, C58, C59, C60: 0.1uF; C_0805_2012Metric
C23, C27, C31, C35, C39, C43, C47, C51: 0.01uF; C_0805_2012Metric
C61: 47uF; C_0805_2012Metric
D1: TPD1E10B06DPYR; R_0805_2012Metric
D2, D5, D6, D7: LED; LED_0805_2012Metric_Pad1.15x1.40mm_HandSolder
D3, D4: MBR0530T1G; D_SOD-123
F1: 500mA; Fuse_1206_3216Metric_Pad1.42x1.75mm_HandSolder
H1, H2, H3, H4: MountingHole_Pad; MountingHole_2.2mm_M2_Pad_TopBottom
J1: 1054500101; CONN_105450-0101_MOL
J2, J5, J6, J7, J14, J15, J16, J17, J18, J19: Conn_01x02_Pin; PinHeader_1x02_P2.54mm_Vertical
J3: Conn_01x02_Pin; TerminalBlock_Phoenix_PT-1,5-2-3.5-H_1x02_P3.50mm_Horizontal
J4: Conn_01x08_Pin; PinHeader_1x08_P2.54mm_Vertical
J11, J12: Conn_01x04_Pin; PinHeader_1x04_P2.54mm_Vertical
J20: Conn_01x07_Pin; PinHeader_1x07_P2.54mm_Vertical
L1: 10uH; L_0805_2012Metric
L2, L3: 22uH; L_0805_2012Metric
R1: 147k; R_0805_2012Metric
R2, R5, R86, R88, R89: 0; R_0805_2012Metric
R3: 1.91k; R_0805_2012Metric
R4: 13.3k; R_0805_2012Metric
R6: 40.2k; R_0805_2012Metric
R7: 3.6k; R_0805_2012Metric
R8, R9, R10, R11, R12, R13, R22, R23, R24, R25, R29, R30, R32, R33, R36, R44, R48, R49, R50, R51, R52, R53, R54, R55, R84, R85: 4.7k; R_0805_2012Metric
R14, R15, R16, R17, R18, R19, R20, R21, R26, R27, R28, R31, R34, R35, R37, R38, R39, R40, R41, R42, R43, R45, R46, R47, R56, R57, R62, R63, R64, R65, R70, R71, R76, R77, R82, R83, R90, R91, R92, R93, R94, R95, R96: 100; R_0805_2012Metric
R58, R59, R60, R61, R66, R67, R68, R69, R72, R73, R74, R75, R78, R79, R80, R81, R87: 1K; R_0805_2012Metric
R97, R98: 5.1k; R_0805_2012Metric
R99: 120; R_0805_2012Metric
R100: 290; R_0805_2012Metric
R101, R102: 1.3k; R_0805_2012Metric
TP1, TP2, TP3, TP4, TP5, TP6, TP7, TP8, TP9, TP10, TP11, TP12, TP13, TP14, TP15, TP16, TP17, TP18, TP19, TP20, TP21, TP22, TP23, TP24, TP25, TP26, TP27, TP28, TP29: TestPoint; TestPoint_Pad_1.0x1.0mm
U1: LM2733YMFX/NOPB; MF05A
U2: AZ1117IH-3.3TRG1; SOT223_AZ1117I_6P5X3P5_DIO
U3: LM2611BMF/NOPB; DBV0005A_L
U4: 74HC139N; SO-16_3.9x9.9mm_P1.27mm
U5: 74HC154D; SOP-24_7.5x15.4mm_P1.27mm
U6, U7, U8, U9, U10, U13, U16, U19, U22, U25, U28, U31: LTC2630ISC6-LZ8-TRMPBF; SOT-363_SC-70-6_Handsoldering
U11, U14, U17, U20, U23, U26, U29, U32: SN74LVC1G3157DCKR; SOT-23-6_Handsoldering
U12, U15, U18, U21, U24, U27, U30, U33: AD633ARZ-R7; R_8_ADI
U34: LTC2353ILX-16-PBF; LQFP-48_7x7mm_P0.5mm

Connections:
+3.3V: C12.1, C17.1, C18.1, C59.1, J4.5, J4.7, J6.2, J12.1, J12.3, R99.1, U4.16 (VCC), U5.24 (VCC), U34.31 (OVDD)
+5V: C1.1, C2.1, C3.1, C7.2, C10.1, C14.1, C19.1, C20.1, C21.1, C22.1, C23.1, C24.1, C27.1, C28.1, C31.1, C32.1, C35.1, C36.1, C39.1, C40.1, C43.1, C44.1, C47.1, C48.1, C51.1, C52.1, C55.1, D1.1, F1.2, L1.1, L2.1, R2.1, R5.1, R100.1, U1.5 (VIN), U2.3 (INPUT), U3.5 (VIN), U6.4 (VCC), U7.4 (VCC), U8.4 (VCC), U9.4 (VCC), U10.4 (VCC), U11.5 (VCC), U13.4 (VCC), U14.5 (VCC), U16.4 (VCC), U17.5 (VCC), U19.4 (VCC), U20.5 (VCC), U22.4 (VCC), U23.5 (VCC), U25.4 (VCC), U26.5 (VCC), U28.4 (VCC), U29.5 (VCC), U31.4 (VCC), U32.5 (VCC), U34.42 (VDD), U34.43 (VDD)
+15V: C25.1, C29.1, C33.1, C37.1, C41.1, C45.1, C49.1, C53.1, C57.1, J5.2, R101.1, U12.6 (+VS), U15.6 (+VS), U18.6 (+VS), U21.6 (+VS), U24.6 (+VS), U27.6 (+VS), U30.6 (+VS), U33.6 (+VS), U34.16 (VCC)
-15V: C26.1, C30.1, C34.1, C38.1, C42.1, C46.1, C50.1, C54.1, C58.1, D7.1 (K), J7.2, U12.3 (-VS), U15.3 (-VS), U18.3 (-VS), U21.3 (-VS), U24.3 (-VS), U27.3 (-VS), U30.3 (-VS), U33.3 (-VS), U34.17 (VEE), U34.45 (VEE)
/ADC/ADC1_BUSY_OUT_R: J20.7, R96.2
/ADC/ADC1_CS_L_R: J20.1, R90.2
/ADC/ADC1_EXTERNAL_REFIN: C60.1, R86.1, TP23.1, U34.19 (REFIN)
/ADC/ADC1_EXTERN_REF: R89.2, TP24.1
/ADC/ADC1_POWER_DOWN: R87.1, U34.22 (PD)
/ADC/ADC1_REF: C61.1, R89.1, U34.21 (REFBUF)
/ADC/ADC1_SCLK_R: J20.2, R91.2
/ADC/ADC1_SDI_R: J20.3, R92.2
/ADC/ADC1_SDO_CH0_R: J20.4, R93.2
/ADC/ADC1_SDO_CH1_R: J20.5, R94.2
/ADC/ADC1_VDDLBYP: C56.1, U34.40 (VDDLBYP)
/ADC/IN0: R85.1, TP22.1, U34.9 (IN0)
/ADC/IN1: R84.1, TP21.1, U34.3 (IN1)
/ADC/TP_ADC1_CLK_OUT_R: J20.6, R95.2
/ADC/TP_ADC1_SDI_N: TP28.1, U34.27 (SDI)
/ADC/TP_ADC1_SDI_P: TP29.1, U34.26 (SDI+)
/ADC/TP_ADC1_SDO_N: TP25.1, U34.35 (SDO)
/ADC/TP_ADC1_SDO_P: TP27.1, U34.34 (SDO+)
/ANALOG MULTIPLIER 1/DAC1_VOUT: TP13.1, U10.6 (VOUT), U11.4 (A)
/ANALOG MULTIPLIER 1/DAC2_VOUT: TP14.1, U13.6 (VOUT), U14.4 (A)
/ANALOG MULTIPLIER 1/DAC_CLK_R: J15.1, R62.2
/ANALOG MULTIPLIER 1/DAC_DATA_IN_R: J15.2, R64.2
/ANALOG MULTIPLIER 1/GPIO_SW1_POLARITY: R63.1, U11.6 (S)
/ANALOG MULTIPLIER 1/GPIO_SW1_POLARITY_R: J16.1, R63.2
/ANALOG MULTIPLIER 1/GPIO_SW2_POLARITY: R65.1, U14.6 (S)
/ANALOG MULTIPLIER 1/GPIO_SW2_POLARITY_R: J16.2, R65.2
/ANALOG MULTIPLIER 1/MULT1_Y1: R58.1, U11.1 (B2), U12.1 (Y1)
/ANALOG MULTIPLIER 1/MULT1_Y2: R59.1, U11.3 (B1), U12.2 (Y2)
/ANALOG MULTIPLIER 1/MULT2_Y1: R60.1, U14.1 (B2), U15.1 (Y1)
/ANALOG MULTIPLIER 1/MULT2_Y2: R61.1, U14.3 (B1), U15.2 (Y2)
/ANALOG MULTIPLIER 2/DAC5_VOUT: TP15.1, U16.6 (VOUT), U17.4 (A)
/ANALOG MULTIPLIER 2/DAC6_VOUT: TP16.1, U19.6 (VOUT), U20.4 (A)
/ANALOG MULTIPLIER 2/GPIO_SW5_POLARITY: R70.1, U17.6 (S)
/ANALOG MULTIPLIER 2/GPIO_SW5_POLARITY_R: J17.1, R70.2
/ANALOG MULTIPLIER 2/GPIO_SW6_POLARITY: R71.1, U20.6 (S)
/ANALOG MULTIPLIER 2/GPIO_SW6_POLARITY_R: J17.2, R71.2
/ANALOG MULTIPLIER 2/MULT5_Y1: R66.1, U17.1 (B2), U18.1 (Y1)
/ANALOG MULTIPLIER 2/MULT5_Y2: R67.1, U17.3 (B1), U18.2 (Y2)
/ANALOG MULTIPLIER 2/MULT6_Y1: R68.1, U20.1 (B2), U21.1 (Y1)
/ANALOG MULTIPLIER 2/MULT6_Y2: R69.1, U20.3 (B1), U21.2 (Y2)
/ANALOG MULTIPLIER 3/DAC9_VOUT: TP17.1, U22.6 (VOUT), U23.4 (A)
/ANALOG MULTIPLIER 3/DAC10_VOUT: TP18.1, U25.6 (VOUT), U26.4 (A)
/ANALOG MULTIPLIER 3/GPIO_SW9_POLARITY: R76.1, U23.6 (S)
/ANALOG MULTIPLIER 3/GPIO_SW9_POLARITY_R: J18.1, R76.2
/ANALOG MULTIPLIER 3/GPIO_SW10_POLARITY: R77.1, U26.6 (S)
/ANALOG MULTIPLIER 3/GPIO_SW10_POLARITY_R: J18.2, R77.2
/ANALOG MULTIPLIER 3/MULT9_Y1: R72.1, U23.1 (B2), U24.1 (Y1)
/ANALOG MULTIPLIER 3/MULT9_Y2: R73.1, U23.3 (B1), U24.2 (Y2)
/ANALOG MULTIPLIER 3/MULT10_Y1: R74.1, U26.1 (B2), U27.1 (Y1)
/ANALOG MULTIPLIER 3/MULT10_Y2: R75.1, U26.3 (B1), U27.2 (Y2)
/ANALOG MULTIPLIER 4/DAC13_VOUT: TP19.1, U28.6 (VOUT), U29.4 (A)
/ANALOG MULTIPLIER 4/DAC14_VOUT: TP20.1, U31.6 (VOUT), U32.4 (A)
/ANALOG MULTIPLIER 4/GPIO_SW13_POLARITY: R82.1, U29.6 (S)
/ANALOG MULTIPLIER 4/GPIO_SW13_POLARITY_R: J19.1, R82.2
/ANALOG MULTIPLIER 4/GPIO_SW14_POLARITY: R83.1, U32.6 (S)
/ANALOG MULTIPLIER 4/GPIO_SW14_POLARITY_R: J19.2, R83.2
/ANALOG MULTIPLIER 4/MULT13_Y1: R78.1, U29.1 (B2), U30.1 (Y1)
/ANALOG MULTIPLIER 4/MULT13_Y2: R79.1, U29.3 (B1), U30.2 (Y2)
/ANALOG MULTIPLIER 4/MULT14_Y1: R80.1, U32.1 (B2), U33.1 (Y1)
/ANALOG MULTIPLIER 4/MULT14_Y2: R81.1, U32.3 (B1), U33.2 (Y2)
/DAC INPUTS/DAC_IN_CLK_R: J14.1, R56.2
/DAC INPUTS/DAC_IN_DATA_IN_R: J14.2, R57.2
/DECODER 1/ADC1_CS_L_R: R15.1, U4.12 (2Y*0)
/DECODER 1/ADC2_CS_L_R: R17.1, U4.11 (2Y*1)
/DECODER 1/ADC3_CS_L_R: R19.1, U4.10 (2Y*2)
/DECODER 1/ADC4_CS_L_R: R21.1, U4.9 (2Y*3)
/DECODER 1/ADC_DECODER_A0: J4.2, R12.1, U4.14 (2A0)
/DECODER 1/ADC_DECODER_A1: J4.1, R13.1, U4.13 (2A1)
/DECODER 1/ADC_DECODER_EN_L: J4.6, R9.1, U4.15 (2E*)
/DECODER 1/DAC_IN1_CS_L_R: R20.2, U4.7 (1Y*3)
/DECODER 1/DAC_IN2_CS_L_R: R18.2, U4.6 (1Y*2)
/DECODER 1/DAC_IN3_CS_L_R: R16.2, U4.5 (1Y*1)
/DECODER 1/DAC_IN4_CS_L_R: R14.2, U4.4 (1Y*0)
/DECODER 1/DAC_IN_DECODER_A0: J4.4, R10.1, U4.2 (1A0)
/DECODER 1/DAC_IN_DECODER_A1: J4.3, R11.1, U4.3 (1A1)
/DECODER 1/DAC_IN_DECODER_EN_L: J4.8, R8.1, U4.1 (1E*)
/DECODER 1/TP_ADC1_CS_L: R15.2, R22.1, TP1.1
/DECODER 1/TP_ADC2_CS_L: R17.2, R23.1, TP2.1
/DECODER 1/TP_ADC3_CS_L: R19.2, R24.1, TP3.1
/DECODER 1/TP_ADC4_CS_L: R21.2, R25.1, TP4.1
/DECODER 2/DAC1_CS_L_R: R26.1, U5.1 (Y0*)
/DECODER 2/DAC2_CS_L_R: R27.1, U5.2 (Y1*)
/DECODER 2/DAC3_CS_L: R28.2, R48.1, TP5.1
/DECODER 2/DAC3_CS_L_R: R28.1, U5.3 (Y2*)
/DECODER 2/DAC4_CS_L: R31.2, R49.1, TP7.1
/DECODER 2/DAC4_CS_L_R: R31.1, U5.4 (Y3*)
/DECODER 2/DAC5_CS_L_R: R34.1, U5.5 (Y4*)
/DECODER 2/DAC6_CS_L_R: R35.1, U5.6 (Y5*)
/DECODER 2/DAC7_CS_L: R37.2, R50.1, TP9.1
/DECODER 2/DAC7_CS_L_R: R37.1, U5.7 (Y6*)
/DECODER 2/DAC8_CS_L: R39.2, R51.1, TP11.1
/DECODER 2/DAC8_CS_L_R: R39.1, U5.8 (Y7*)
/DECODER 2/DAC9_CS_L_R: R41.1, U5.9 (Y8*)
/DECODER 2/DAC10_CS_L_R: R43.1, U5.10 (Y9*)
/DECODER 2/DAC11_CS_L: R46.2, R55.1, TP6.1
/DECODER 2/DAC11_CS_L_R: R46.1, U5.11 (Y10*)
/DECODER 2/DAC12_CS_L: R47.1, R54.1, TP8.1
/DECODER 2/DAC12_CS_L_R: R47.2, U5.13 (Y11*)
/DECODER 2/DAC13_CS_L_R: R45.2, U5.14 (Y12*)
/DECODER 2/DAC14_CS_L_R: R42.2, U5.15 (Y13*)
/DECODER 2/DAC15_CS_L: R40.1, R53.1, TP10.1
/DECODER 2/DAC15_CS_L_R: R40.2, U5.16 (Y14*)
/DECODER 2/DAC16_CS_L: R38.1, R52.1, TP12.1
/DECODER 2/DAC16_CS_L_R: R38.2, U5.17 (Y15*)
/DECODER 2/DAC_DECODER_E0_L: J12.4, R44.1, U5.18 (E0*)
/DECODER 2/DAC_DECODER_E1_L: J12.2, R36.1, U5.19 (E1*)
/POWER/BOOST1_FB: C8.2, R3.2, R4.1, U1.3 (FB)
/POWER/BOOST1_FB_R: R1.2, R3.1
/POWER/BOOST1_LX: D3.2 (A), L1.2, U1.1 (SW)
/POWER/BOOST1_SHDN: R2.2, U1.4 (~SHDN)
/POWER/CUK1_FB: C15.2, R6.2, R7.1, U3.3 (NFB)
/POWER/CUK1_LX: C13.2, L2.2, U3.1 (SW)
/POWER/CUK1_LX_C: C13.1, D4.2 (A), L3.1
/POWER/CUK1_SHDN: R5.2, U3.4 (SHDN_N)
/POWER/PN15V0_CUK: C15.1, C16.1, J7.1, L3.2, R6.1
/POWER/PP3V3_LDO: C11.1, J6.1, U2.2 (OUTPUT)
/POWER/PP15V0_BOOST: C8.1, C9.1, D3.1 (K), J5.1, R1.1
/USBC RECEPTACLE/LMAO: F1.1, J2.2, J3.2
/USBC RECEPTACLE/PP5V0_USBC: J1.A4, J1.A9, J1.B4, J1.B9, J2.1
ADC1_BUSY_OUT: R96.1, U34.38 (BUSY)
ADC1_CS_L: R90.1, U34.24 (CNV), U34.39 (*CS)
ADC1_SCLK: R91.1, U34.29 (SCKI/SCKI)
ADC1_SDI: R92.1, U34.37 (SDI)
ADC1_SDO_CH0: R93.1, U34.28 (SCKI+/SDO0)
ADC1_SDO_CH1: R94.1, U34.33 (SCKO/SDO1)
DAC1_CS_L: R26.2, U10.1 (*CS/LD)
DAC2_CS_L: R27.2, U13.1 (*CS/LD)
DAC5_CS_L: R34.2, U16.1 (*CS/LD)
DAC6_CS_L: R35.2, U19.1 (*CS/LD)
DAC9_CS_L: R41.2, U22.1 (*CS/LD)
DAC10_CS_L: R43.2, U25.1 (*CS/LD)
DAC13_CS_L: R45.1, U28.1 (*CS/LD)
DAC14_CS_L: R42.1, U31.1 (*CS/LD)
DAC_CLK: R62.1, U10.2 (SCK), U13.2 (SCK), U16.2 (SCK), U19.2 (SCK), U22.2 (SCK), U25.2 (SCK), U28.2 (SCK), U31.2 (SCK)
DAC_DATA_IN: R64.1, U10.3 (SDI), U13.3 (SDI), U16.3 (SDI), U19.3 (SDI), U22.3 (SDI), U25.3 (SDI), U28.3 (SDI), U31.3 (SDI)
DAC_DECODER_A0: J11.1, R29.1, U5.23 (A0)
DAC_DECODER_A1: J11.2, R30.1, U5.22 (A1)
DAC_DECODER_A2: J11.3, R32.1, U5.21 (A2)
DAC_DECODER_A3: J11.4, R33.1, U5.20 (A3)
DAC_IN1_CS_L: R20.1, U6.1 (*CS/LD)
DAC_IN2_CS_L: R18.1, U7.1 (*CS/LD)
DAC_IN3_CS_L: R16.1, U8.1 (*CS/LD)
DAC_IN4_CS_L: R14.1, U9.1 (*CS/LD)
DAC_IN_CLK: R56.1, U6.2 (SCK), U7.2 (SCK), U8.2 (SCK), U9.2 (SCK)
DAC_IN_DATA_IN: R57.1, U6.3 (SDI), U7.3 (SDI), U8.3 (SDI), U9.3 (SDI)
GND: C1.2, C2.2, C3.2, C7.1, C9.2, C10.2, C11.2, C12.2, C14.2, C16.2, C17.2, C18.2, C19.2, C20.2, C21.2, C22.2, C23.2, C24.2, C25.2, C26.2, C27.2, C28.2, C29.2, C30.2, C31.2, C32.2, C33.2, C34.2, C35.2, C36.2, C37.2, C38.2, C39.2, C40.2, C41.2, C42.2, C43.2, C44.2, C45.2, C46.2, C47.2, C48.2, C49.2, C50.2, C51.2, C52.2, C53.2, C54.2, C55.2, C56.2, C57.2, C58.2, C59.2, C60.2, C61.2, D1.2, D2.1 (K), D4.1 (K), D5.1 (K), D6.1 (K), H1.1, H2.1, H3.1, H4.1, J1.A1, J1.A12, J1.B1, J1.B12, J3.1, R4.2, R7.2, R8.2, R9.2, R10.2, R11.2, R12.2, R13.2, R22.2, R23.2, R24.2, R25.2, R29.2, R30.2, R32.2, R33.2, R36.2, R44.2, R48.2, R49.2, R50.2, R51.2, R52.2, R53.2, R54.2, R55.2, R58.2, R59.2, R60.2, R61.2, R66.2, R67.2, R68.2, R69.2, R72.2, R73.2, R74.2, R75.2, R78.2, R79.2, R80.2, R81.2, R84.2, R85.2, R86.2, R87.2, R88.2, R97.2, R98.2, R102.1, U1.2 (GND), U2.1 (ADJ/GND), U3.2 (GND), U4.8 (GND), U5.12 (GND), U6.5 (GND), U7.5 (GND), U8.5 (GND), U9.5 (GND), U10.5 (GND), U11.2 (GND), U12.4 (Z), U12.8 (X2), U13.5 (GND), U14.2 (GND), U15.4 (Z), U15.8 (X2), U16.5 (GND), U17.2 (GND), U18.8 (X2), U19.5 (GND), U20.2 (GND), U21.8 (X2), U22.5 (GND), U23.2 (GND), U24.8 (X2), U25.5 (GND), U26.2 (GND), U27.8 (X2), U28.5 (GND), U29.2 (GND), U30.8 (X2), U31.5 (GND), U32.2 (GND), U33.8 (X2), U34.1 (GND), U34.2 (GND), U34.5 (GND), U34.6 (GND), U34.7 (GND), U34.8 (GND), U34.11 (GND), U34.12 (GND), U34.13 (GND), U34.14 (GND), U34.15 (GND), U34.18 (GND), U34.20 (GND), U34.25 (GND), U34.30 (GND), U34.36 (GND), U34.41 (GND), U34.44 (GND), U34.46 (GND), U34.47 (GND), U34.48 (GND)
IN1: U6.6 (VOUT), U12.7 (X1), U15.7 (X1)
IN2: U7.6 (VOUT), U18.7 (X1), U21.7 (X1)
IN3: U8.6 (VOUT), U24.7 (X1), U27.7 (X1)
IN4: U9.6 (VOUT), U30.7 (X1), U33.7 (X1)
MULT1_OUT: U12.5 (W), U18.4 (Z)
MULT2_OUT: U15.5 (W), U21.4 (Z)
MULT5_OUT: U18.5 (W), U24.4 (Z)
MULT6_OUT: U21.5 (W), U27.4 (Z)
MULT9_OUT: U24.5 (W), U30.4 (Z)
MULT10_OUT: U27.5 (W), U33.4 (Z)
MULT13_OUT: U30.5 (W), U34.4 (IN1+)
MULT14_OUT: U33.5 (W), U34.10 (IN0+)
unnamed: D2.2 (A), R99.2
unnamed: D5.2 (A), R100.2
unnamed: D6.2 (A), R101.2
unnamed: D7.2 (A), R102.2
unnamed: J1.A5, R97.1
unnamed: J1.B5, R98.1
unnamed: R88.1, U34.23 (LVDS/*CMOS)
TP_ADC1_CLK_OUT: R95.1, TP26.1, U34.32 (SCKO+/SCKO)
