mingzejin11/FYDP/(commit log)

2024-01-29 Remove 2 channels of multiplier and change ADC
    [ADC.kicad_sch, ADC_1.kicad_sch, ADC_2.kicad_sch, ADC_3.kicad_sch, ADC_4.kicad_sch, Analog Multiplier 1.kicad_sch, Analog Multiplier 2.kicad_sch, Analog Multiplier 3.kicad_sch]
2024-01-29 Edit schematic titles
    [Analog Multiplier 1.kicad_sch, Analog Multiplier 3.kicad_sch, Analog Multiplier 5.kicad_sch, Analog Multiplier 7.kicad_sch, Block_Diagran.kicad_sch, Decoder 1.kicad_sch]
2024-01-29 remove caps on VDD and VEE on ADC
    [ADC.kicad_sch]
2024-02-01 Initial layout mostly complete, need to complete lots of routing
    [ADC.kicad_sch, Analog Multiplier 1.kicad_sch, Analog Multiplier 3.kicad_sch, Analog Multiplier 5.kicad_sch, DECODER 2.kicad_sch, Decoder 1.kicad_sch, fydp.kicad_pcb, power.kicad_sch]
2024-02-01 Completed placement and silk for left and centre sections of the PCB
    [ADC.kicad_sch, Analog Multiplier 1.kicad_sch, Analog Multiplier 3.kicad_sch, Analog Multiplier 5.kicad_sch, Analog Multiplier 7.kicad_sch, DAC Inputs.kicad_sch, DECODER 2.kicad_sch, Decoder 1.kicad_sch]
2024-02-01 Pushing all changes, I'm late for class
    [ADC.kicad_sch, fydp.kicad_pcb]
2024-02-01 Did some work in class lol
    [Decoder 1.kicad_sch, fydp.kicad_pcb]
2024-02-02 Initial layout is pretty much complete, need to add power planes
    [Decoder 1.kicad_sch, USBC_Receptacle.kicad_sch, fydp.kicad_pcb, power.kicad_sch]
2024-02-02 Finished layout
    [SOT223-3.step, SOT23-5.stp, USBC_Receptacle.kicad_sch]
2024-02-06 Generating fab files, still need to make BOM and pick and place
    [fydp-B_Cu.gbr, fydp-B_Mask.gbr, fydp-B_Paste.gbr, fydp-B_Silkscreen.gbr, fydp-Edge_Cuts.gbr, fydp-F_Cu.gbr, fydp-F_Mask.gbr, fydp-F_Paste.gbr]
2024-02-06 Adding JLCPCB BOM notes
    [ADC.kicad_sch, Analog Multiplier 1.kicad_sch, Analog Multiplier 3.kicad_sch, Analog Multiplier 5.kicad_sch, Analog Multiplier 7.kicad_sch, DAC Inputs.kicad_sch, DECODER 2.kicad_sch, Decoder 1.kicad_sch]
2024-02-06 Updating BOM some more
    [ADC.kicad_sch, Analog Multiplier 1.kicad_sch, Analog Multiplier 3.kicad_sch, Analog Multiplier 5.kicad_sch, Analog Multiplier 7.kicad_sch, DAC Inputs.kicad_sch, DECODER 2.kicad_sch, Decoder 1.kicad_sch]
2024-02-07 Pushing laptop changes
    [Analog Multiplier 1.kicad_sch, Analog Multiplier 3.kicad_sch, Analog Multiplier 5.kicad_sch, Analog Multiplier 7.kicad_sch, DAC Inputs.kicad_sch, DECODER 2.kicad_sch, Decoder 1.kicad_sch]
2024-02-07 Fixed footprints
    [ADC.kicad_sch, Analog Multiplier 1.kicad_sch, Analog Multiplier 3.kicad_sch, Analog Multiplier 5.kicad_sch, Analog Multiplier 7.kicad_sch, DAC Inputs.kicad_sch, DECODER 2.kicad_sch, Decoder 1.kicad_sch]
2024-02-07 Updated fabrication files
    [fydp-B_Cu.gbr, fydp-B_Mask.gbr, fydp-B_Paste.gbr, fydp-B_Silkscreen.gbr, fydp-Edge_Cuts.gbr, fydp-F_Cu.gbr, fydp-F_Mask.gbr, fydp-F_Paste.gbr]
2024-02-07 Added BOM and pick and place files
    [fydp-BOM.csv, fydp-pick-and-place.csv, fydp.csv]
2024-02-07 Production files completed
    [fydp-BOM-production.xlsx, fydp-BOM.xlsx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]
2024-02-07 Fixed BOM
    [fydp-BOM-production.xlsx, fydp-BOM.csv, fydp-BOM.xlsx, fydp-pick-and-place.csv, fydp-pick-and-place.xlsx, power.kicad_sch]
2024-02-07 Production underway, Mingze is tired
    [USBC_Receptacle.kicad_sch, fydp-BOM-production.xlsx, fydp-BOM.xlsx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]
2024-03-11 Adding case files
    [FYDP Case bottom.dwg, FYDP Case bottom.dxf, FYDP Case top.dwg, FYDP Case top.dxf, FYDP Case.dwg, FYDP outline.dwg, fydp-B_Cu.dxf, fydp-B_Mask.dxf]
2024-03-12 Adding more case files
    [FYDP Case.dwg, FYDP Case.dxf]
